BreathOfHope/Respirator-2/Electronics/BoHv1_0_Front.png

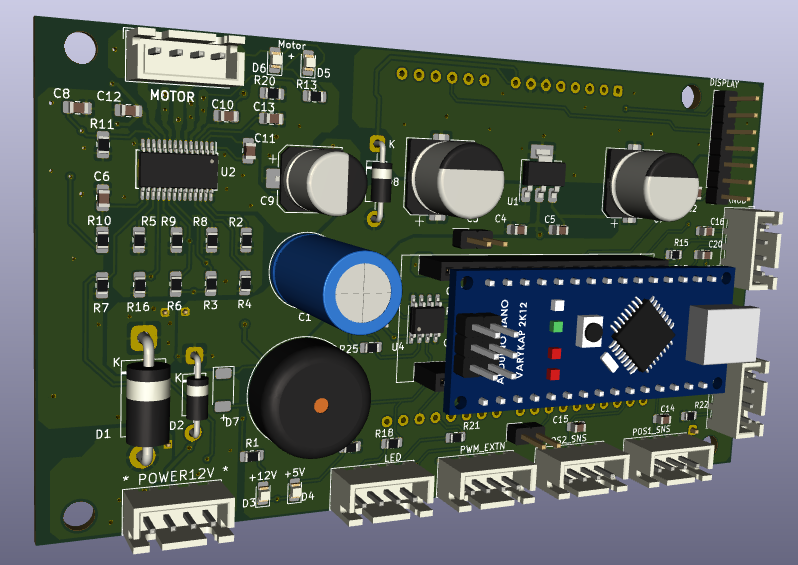
Electronics/BoHv1_0_Front.png
