BreathOfHope/Respirator-2/README.md

# Respirator-2

Respirator-2 takes the knowledge we gained in building the RespiratorApparatus to build a production ready version, that can be manufactured in an industrial setting. If a dire situation arises, this design can be used to mass produce respirators.
