BreathOfHope/Respirator-2/Electronics/PCB_Layout/readme.txt

Project and library files for KiCad based layout, in case you want to modify the layout, else use the gerber files direct.
Use the contents from pretty library for the footprints, some have custom properties.
The project (.pro) file has the reference to the schematics (.sch) and layout(.kicad_pcb) as well as the preferences.
