BreathOfHope/Respirator-2/Electronics/schematic/v0.1/Readme.txt

gEDA based schematics and their pdf versions
Component footprints are hidden but can be edited after selecting the individual component

Modifications needed : Use A4 & A5 pins of the Arduino Nano instead of A6-A7 for the rotary encoder connections. Arduino Uno, if used, would not need any changes.
