BreathOfHope/Respirator-2/Electronics/BoHv1_0_Back.png

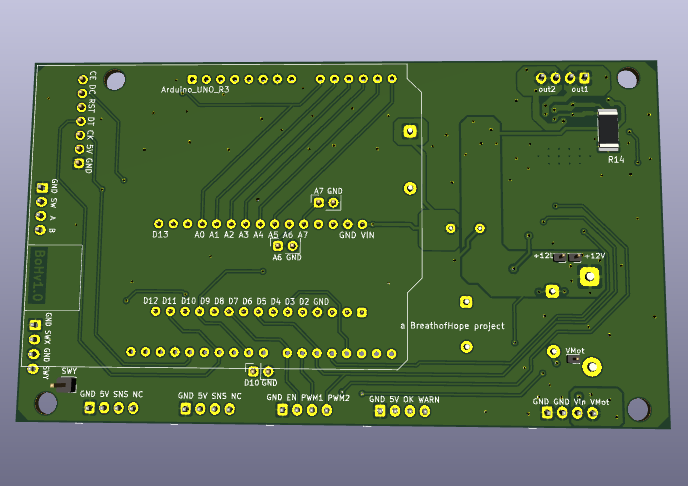
Electronics/BoHv1_0_Back.png
