BreathOfHope/Respirator-2/Mechanical/Respirator mechanical BOM.ods

Part no. | Part name | Material | Unit cost | Quantity | Total cost | Process | Mass(g)
1 | Flange bush | En8 | 150 | 2 | 300 | Turning | 51
2 | Brass bush | Brass | 30 | 2 | 60 | Turning | 20
3 | Frame spacer | En8 | 80 | 4 | 320 | Turning | 96
4 | Crank | MS | 60 | 1 | 60 | Laser cutting | 28.4
5 | Arm spacer | En8 | 80 | 2 | 160 | Turning | 32
6 | Brass bush A | Brass | 60 | 1 | 60 | Turning | 15
7 | Encoder shaft | En8 | 120 | 1 | 120 | Turning | 12
8 | Encoder bush | Al | 100 | 1 | 100 | Turning | 7
9 | Main shaft | En8 | 300 | 1 | 300 | Turning,Milling | 42.6
10 | Brass bush B | Brass | 100 | 1 | 100 | Turning | 16.85
11 | Driven gear insert | Delrin | 120 | 1 | 120 | Turning | 12
12 | Driver geart insert | Delrin | 120 | 1 | 120 | Turning | 9
13 | Frame | MS | 150 | 2 | 300 | Laser cutting | 804.4
14 | Sensor mount | MS | 60 | 1 | 60 | Laser cutting | 117.5
15 | Side bracket | MS | 60 | 2 | 120 | Laser cutting | 184
16 | Power supply mount | MS | 100 | 1 | 200 | Laser cutting | 433
17 | Bottom cover | MS | 250 | 1 | 250 | Laser cutting | 1862.5
18 | Arm plate | MS | 50 | 1 | 50 | Laser cutting | 48
19 | Motor bracket | MS | 100 | 1 | 100 | Laser cutting | 128
20 | Bracket 1 | MS | 50 | 1 | 50 | Laser cutting | 28
21 | Pcb mount | MS | 70 | 1 | 70 | Laser cutting | 259
22 | Enclosure side | MS | 400 | 1 | 400 | Laser cutting | 1682
23 | Encoder cover | MS | 100 | 1 | 100 | Laser cutting | 115
24 | Enclosure top | MS | 150 | 1 | 150 | Laser cutting | 665.27
25 | Enclosure front | MS | 150 | 1 | 150 | Laser cutting | 445
26 | Door | MS | 150 | 1 | 150 | Laser cutting | 510
27 | Arm | MS | 70 | 2 | 140 | Laser cutting | 260
28 | Magnetic lock bracket | MS | 50 | 1 | 50 | Laser cutting
29 | Encoder disc 1 | Acrylic 2mm | 30 | 1 | 30 | Acrylic laser cutting | 6
30 | Spacer 1 | Acrylic 6mm | 20 | 1 | 20 | Acrylic laser cutting | 6
31 | Spacer 2 | Acrylic 3mm | 20 | 1 | 20 | Acrylic laser cutting | 11
32 | Encoder disc 2 | Acrylic 2mm | 30 | 1 | 30 | Acrylic laser cutting | 3.4
33 | Ambu bag support 1 | Acrylic 6mm | 100 | 1 | 100 | Acrylic laser cutting | 6
34 | Ambu bag support 1 | Acrylic 6mm | 100 | 1 | 100 | Acrylic laser cutting | 60
35 | HMI Acrylic sheet 1 | Acrylic 2mm | 30 | 1 | 30 | Acrylic laser cutting | 60
36 | HMI Acrylic sheet 2 | Acrylic 6mm | 60 | 1 | 60 | Acrylic laser cutting | 25
37 | Pcb acrylic mount | Acrylic 4mm | 80 | 1 | 80 | Acrylic laser cutting | 11
38 | Driver gear | Acrylic 8mm | 150 | 1 | 150 | Acrylic laser cutting | 80
39 | Driven gear | Acrylic 5mm | 50 | 1 | 50 | Acrylic laser cutting | 20
40 | Wiper motor 12v | Lucas TVS | 1400 | 1 | 1400 | OTS | 920
41 | Ambu bag
42 | Rubber platfrom
43 | Arm plate rubber sheet
44 | Leg |  | 20 | 4 | 80 | OTS
45 | Magnetic lock |  | 100 | 1 | 100 | OTS
46 | Nut&Bolts |  | 300 | 1 | 300 | OTS
47 | Door hinge lock |  | 100 | 1 | 100 | OTS
 |  |  |  | Total | 6810 |  | 9091.92
