BreathOfHope/Respirator-2/Mechanical/Acrylic laser cutting/8mm clear.dxf

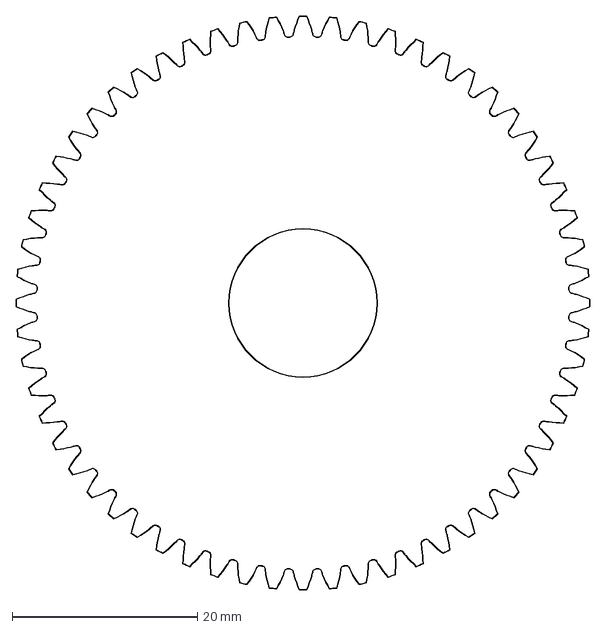
[picture p3: CAD file, 2020-05-19]
Mechanical/Acrylic laser cutting/8mm clear.dxf
62.0 x 62.0 mm
