BreathOfHope/Respirator-2/Mechanical/Metal laser cutting/3mm En8.dxf

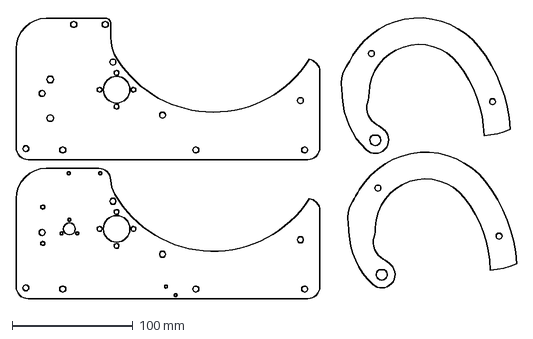
[picture p4: CAD file, 2020-05-19]
Mechanical/Metal laser cutting/3mm En8.dxf
413.9 x 233.5 mm
