BreathOfHope/Respirator-2/Mechanical/Acrylic laser cutting/6mm clear.dxf

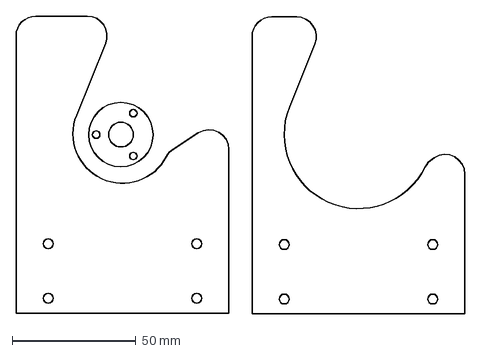
[picture p5: CAD file, 2020-05-19]
Mechanical/Acrylic laser cutting/6mm clear.dxf
181.3 x 120.3 mm
