BreathOfHope/Respirator-2/Mechanical/Metal laser cutting/5mm En8.dxf

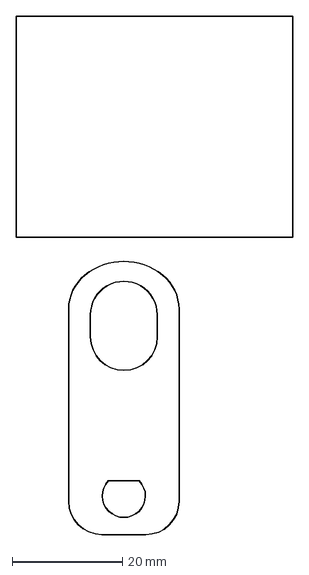
[picture p6: CAD file, 2020-05-19]
Mechanical/Metal laser cutting/5mm En8.dxf
50.0 x 93.8 mm
