BreathOfHope/Respirator-2/Mechanical/Acrylic laser cutting/5mm clear.dxf

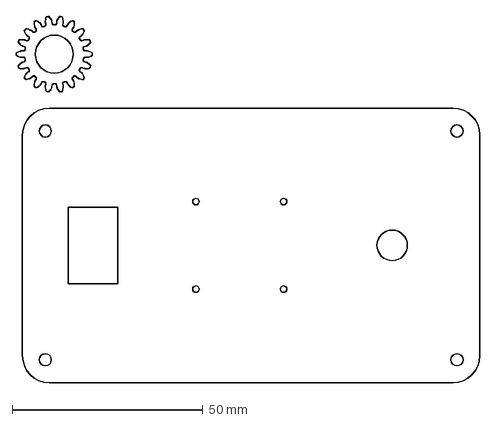
[picture p7: CAD file, 2020-05-19]
Mechanical/Acrylic laser cutting/5mm clear.dxf
121.7 x 96.1 mm
