BreathOfHope/Respirator-2/Mechanical/Metal laser cutting/1.5mm En8.dxf

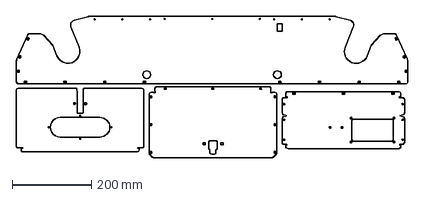
[picture p8: CAD file, 2020-05-19]
Mechanical/Metal laser cutting/1.5mm En8.dxf
986.9 x 356.1 mm
