BreathOfHope/Respirator-2/Mechanical/Acrylic laser cutting/2mm black.dxf

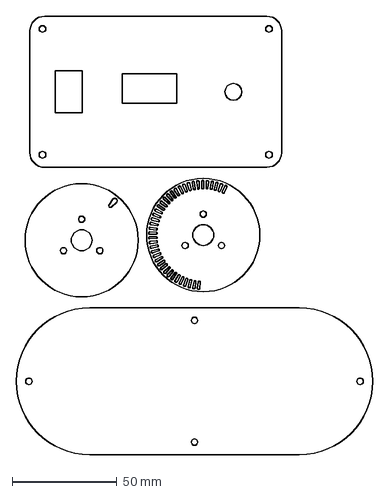
[picture p9: CAD file, 2020-05-19]
Mechanical/Acrylic laser cutting/2mm black.dxf
170.0 x 209.0 mm
