BreathOfHope/Respirator-2/Mechanical/Metal laser cutting/2mm En8.dxf

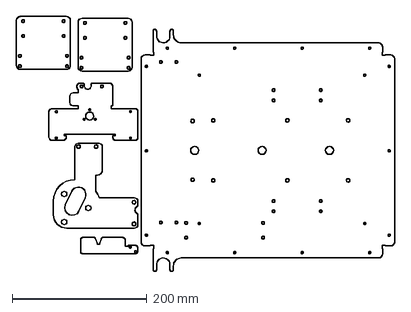
[picture p10: CAD file, 2020-05-19]
Mechanical/Metal laser cutting/2mm En8.dxf
560.8 x 378.2 mm
