BreathOfHope/Respirator-2/Mechanical/Acrylic laser cutting/4mm clear.dxf

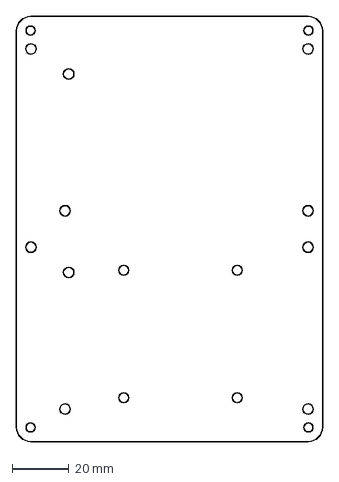
[picture p11: CAD file, 2020-05-19]
Mechanical/Acrylic laser cutting/4mm clear.dxf
108.0 x 150.0 mm
