BreathOfHope/Respirator-2/Mechanical/Metal laser cutting/1mm En8.dxf

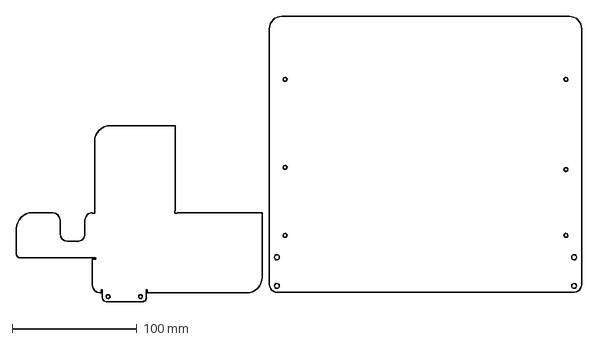
[picture p12: CAD file, 2020-05-19]
Mechanical/Metal laser cutting/1mm En8.dxf
452.7 x 228.6 mm
