BreathOfHope/Respirator-2/Mechanical/Acrylic laser cutting/3mm clear.dxf

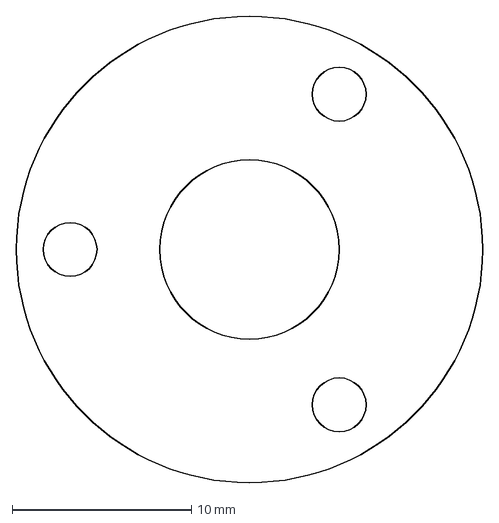
[picture p13: CAD file, 2020-05-19]
Mechanical/Acrylic laser cutting/3mm clear.dxf
26.0 x 26.0 mm
