BreathOfHope/Respirator-2/Electronics/schematic/Resp2.pdf

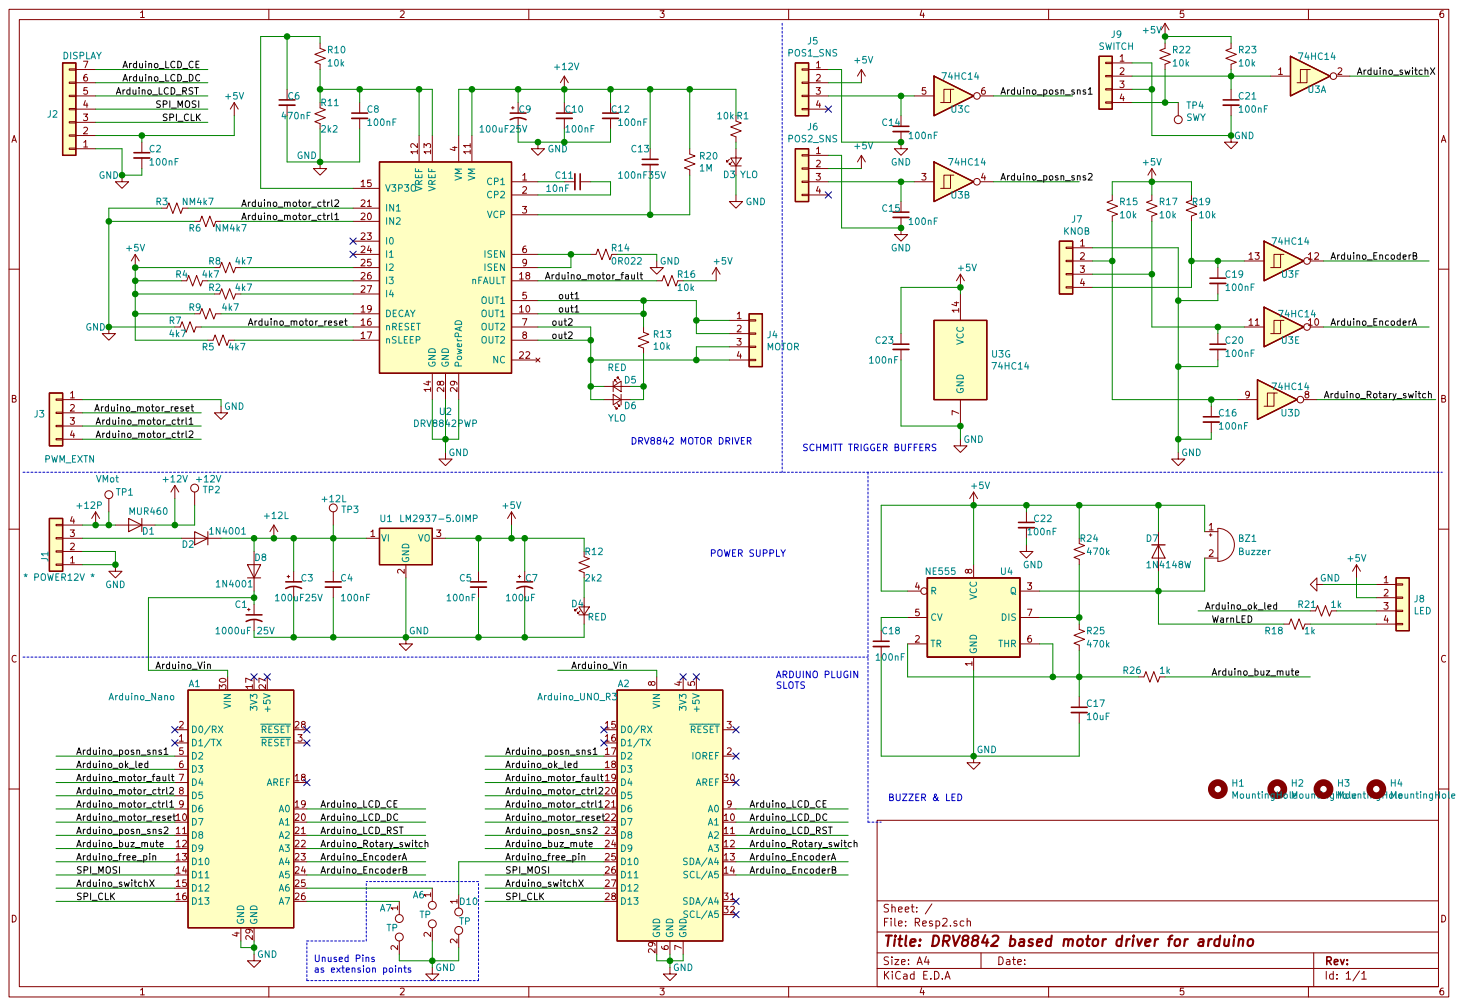
[picture p14: page 1]

SCHMITT TRIGGER BUFFERS DRV8842 MOTOR DRIVER

ARDUINO PLUGIN SLOTS Unused Pins as extension points

File: Resp2.sch Sheet: /
D Date: KiCad E.D.A
Id: 1/1 Title: DRV8842 based motor driver for arduino
