BreathOfHope/Respirator-2/Mechanical/Machining drawings/01 Flange bush.pdf

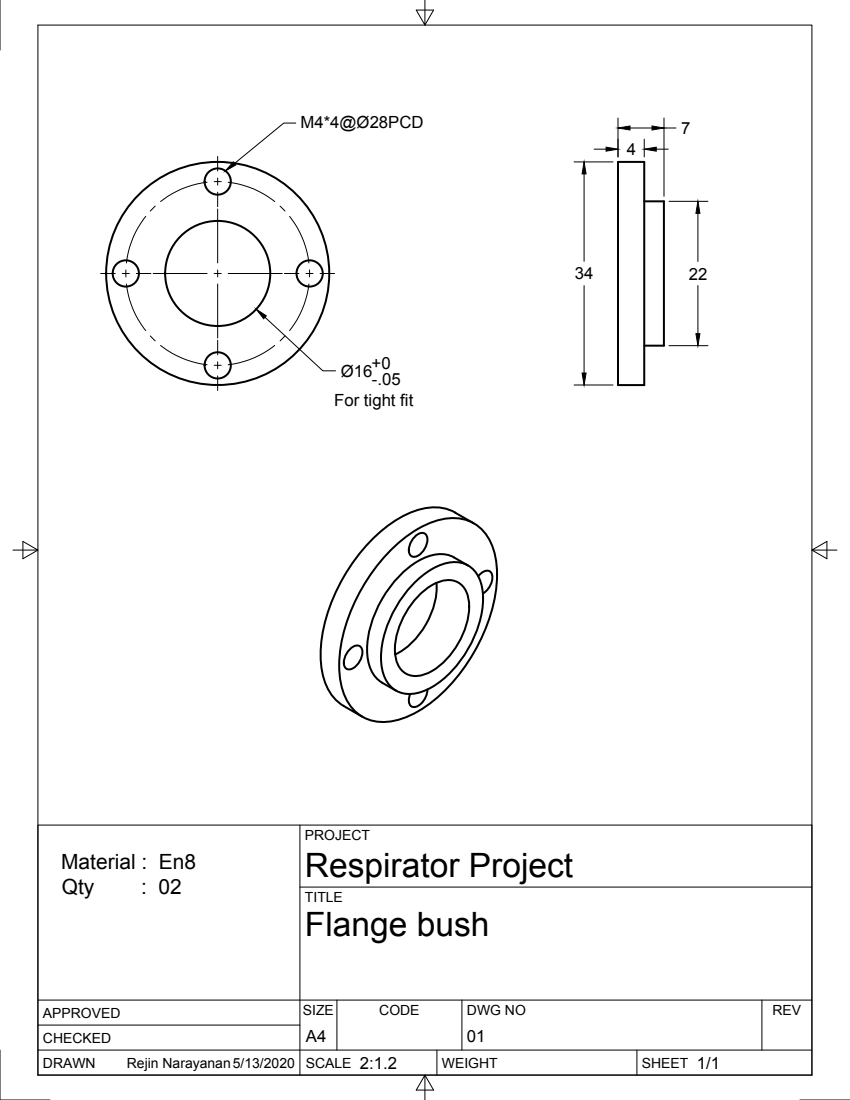
[picture p15: page 1]
SIZE; CODE; DWG NO; REV; Rejin Narayanan5/13/2020; Respirator Project; Flange bush; Material : En8; Qty; For tight fit
