BreathOfHope/Respirator-2/Mechanical/Machining drawings/02 Brass bush.pdf

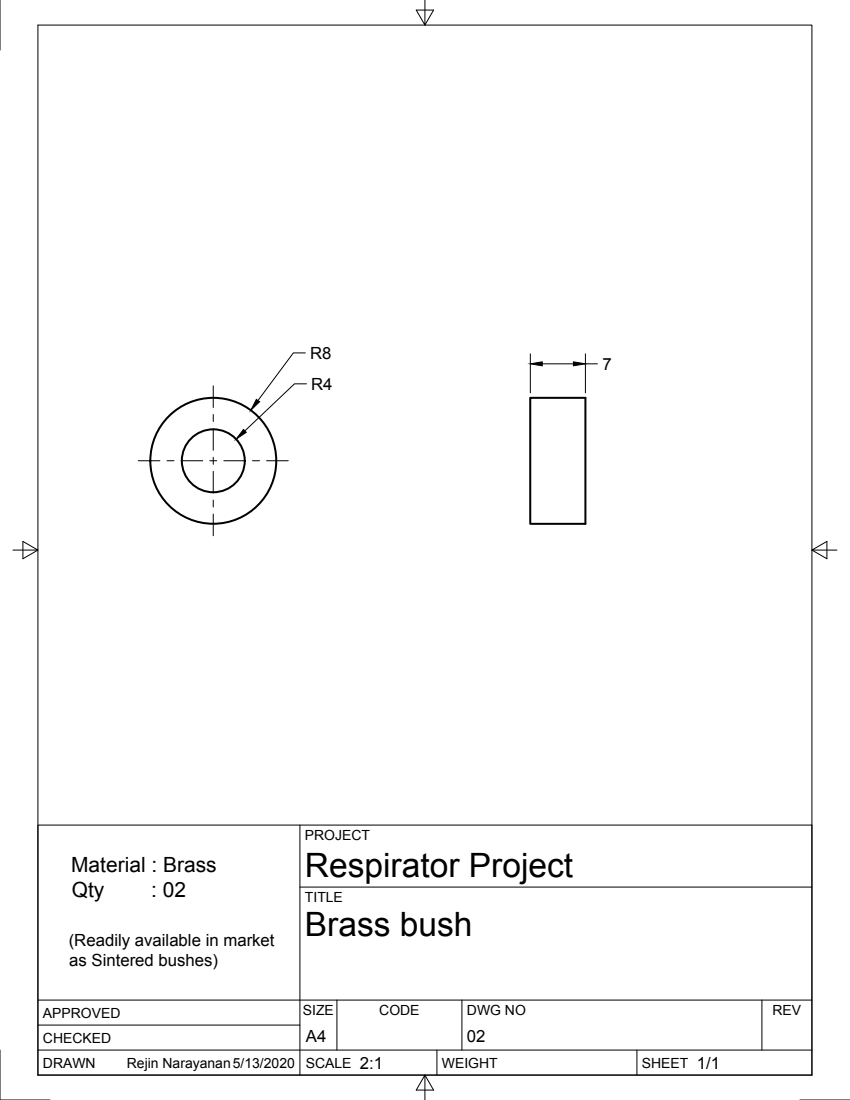
[picture p16: page 1]
SIZE; CODE; DWG NO; REV; Rejin Narayanan5/13/2020; Respirator Project; Brass bush; Material : Brass; Qty

(Readily available in market
as Sintered bushes)
