BreathOfHope/Respirator-2/Mechanical/Machining drawings/03 Frame spacer.pdf

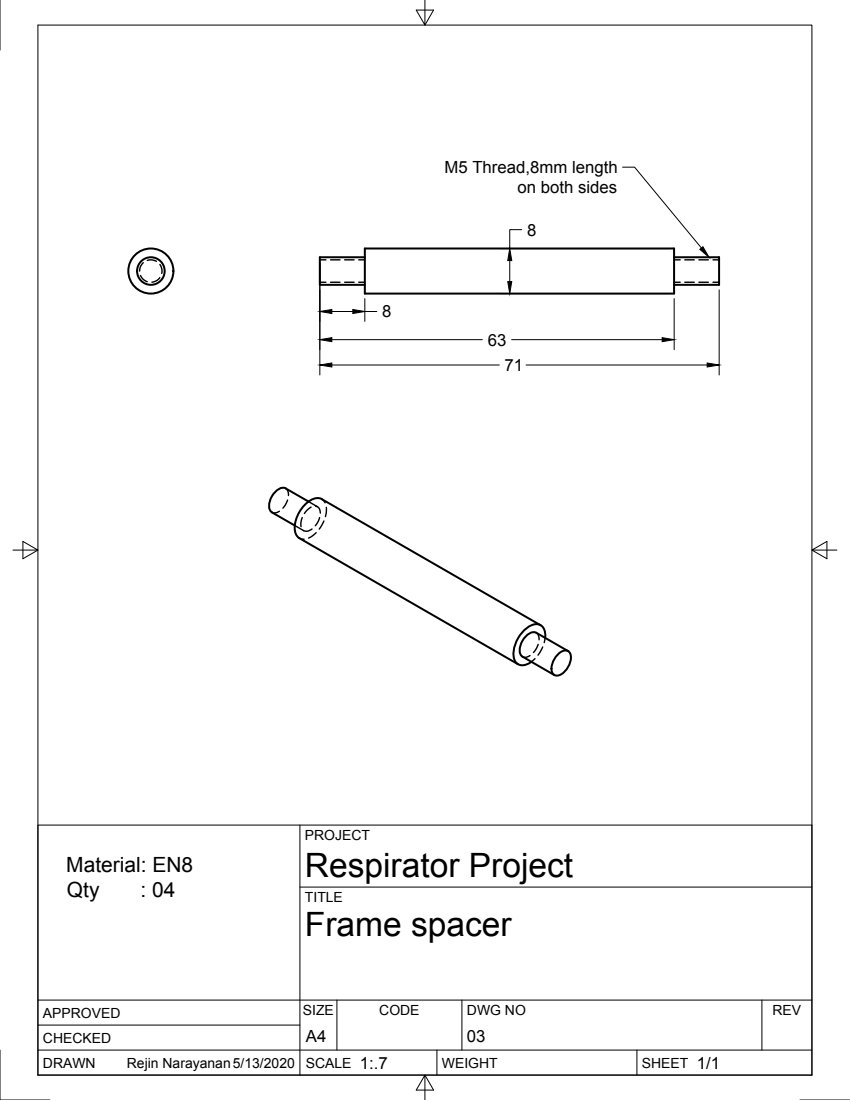
[picture p17: page 1]
SIZE; CODE; DWG NO; REV; Rejin Narayanan5/13/2020; Respirator Project; Frame spacer; M5 Thread,8mm length; Material: EN8; Qty

on both sides
