BreathOfHope/Respirator-2/Mechanical/Machining drawings/04 Crank.pdf

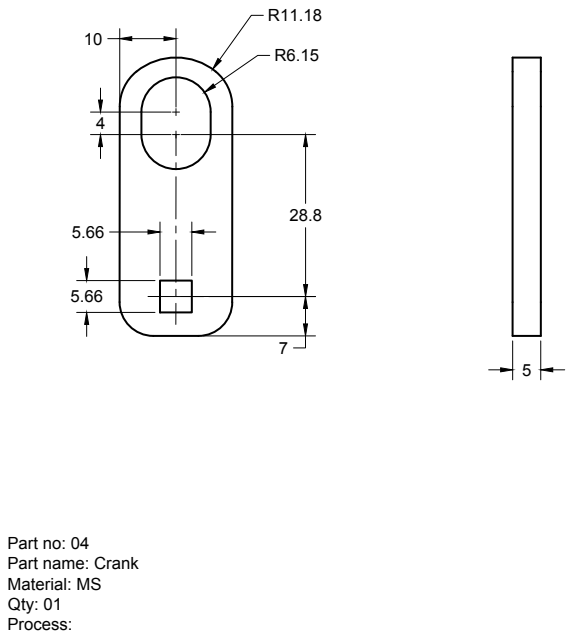
[picture p18: page 1]

Part no: 04
Part name: Crank
Material: MS
Qty: 01
Process:
