BreathOfHope/Respirator-2/Mechanical/Machining drawings/05 Arm spacer.pdf

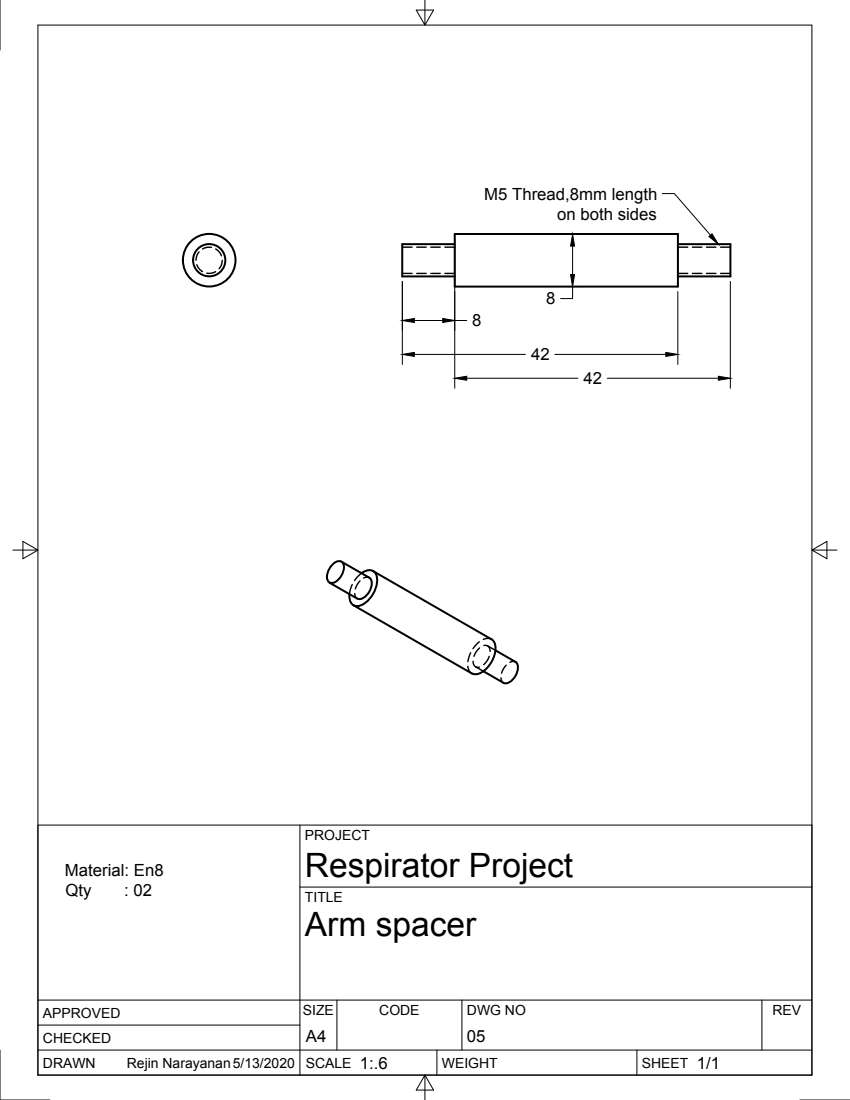
[picture p19: page 1]
SIZE; CODE; DWG NO; REV; Rejin Narayanan5/13/2020; Respirator Project; Arm spacer; M5 Thread,8mm length; Material: En8; Qty

on both sides
