BreathOfHope/Respirator-2/Mechanical/Machining drawings/06 Brass bush A.pdf

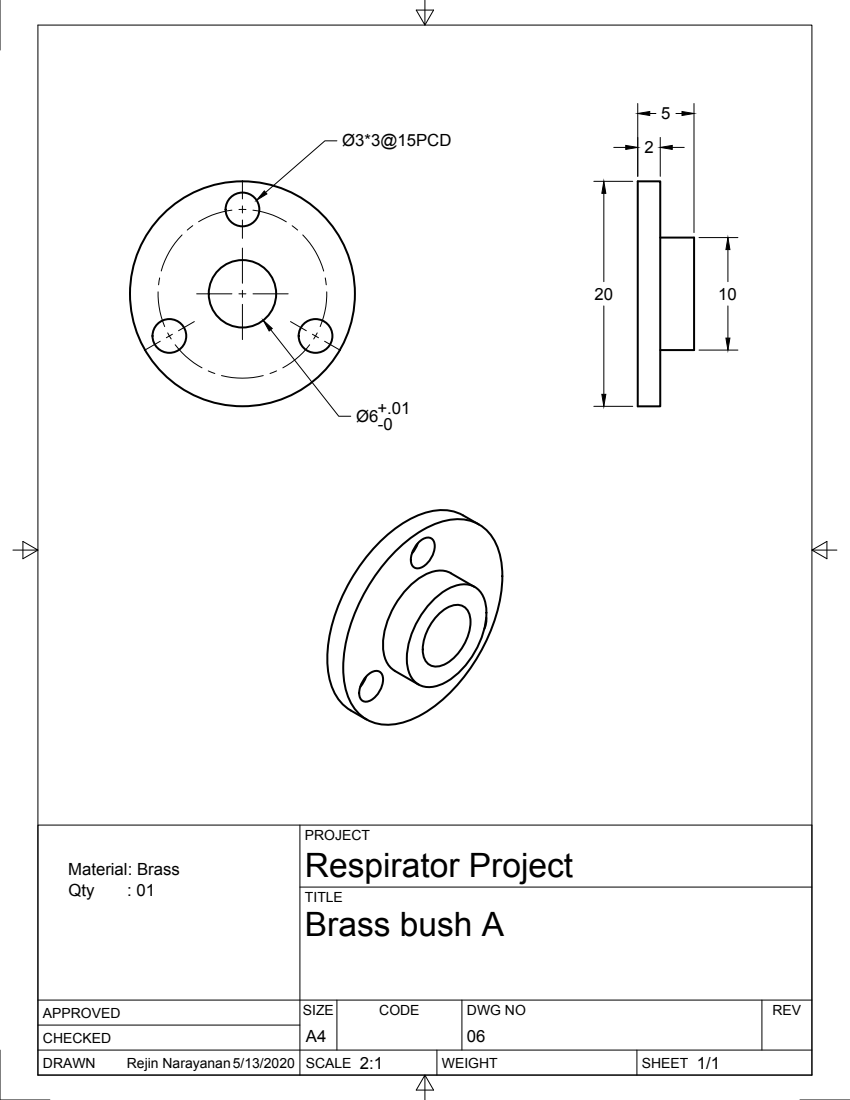
[picture p20: page 1]
SIZE; CODE; DWG NO; REV; Rejin Narayanan5/13/2020; Respirator Project; Brass bush A; Material: Brass; Qty
