BreathOfHope/Respirator-2/Mechanical/Machining drawings/07 Encoder shaft.pdf

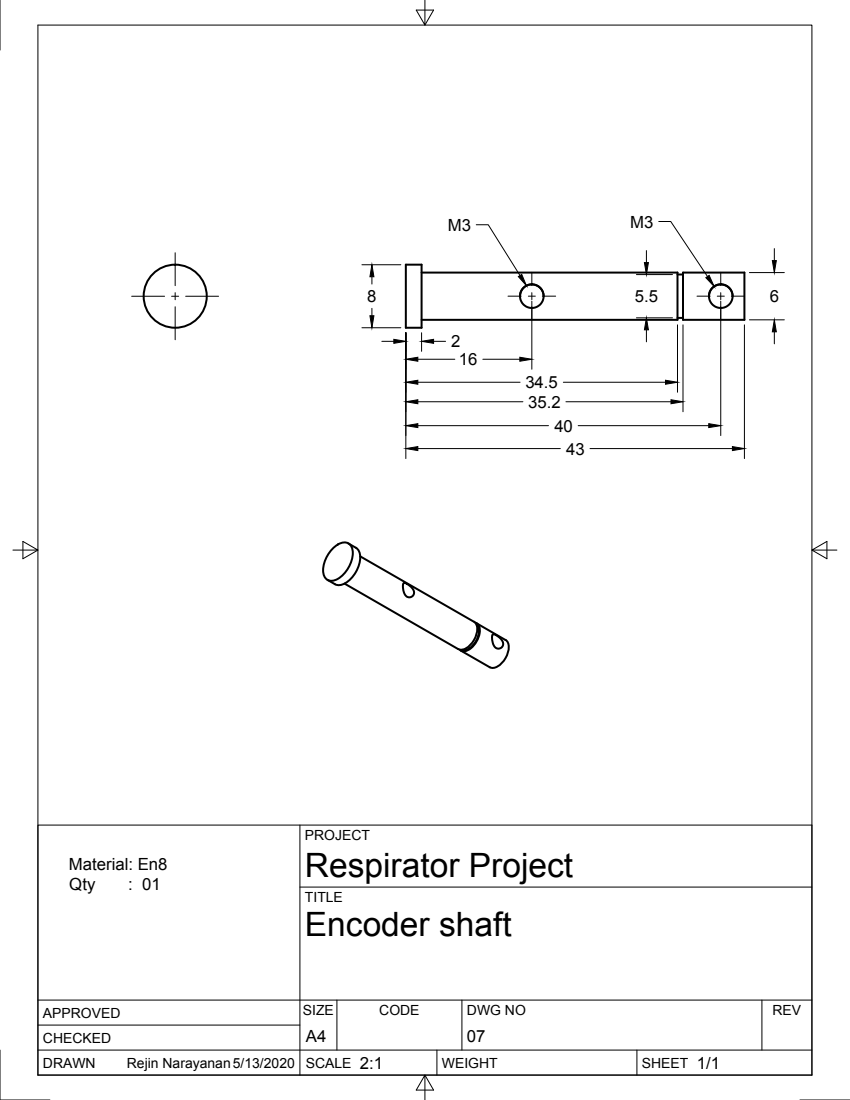
[picture p21: page 1]
SIZE; CODE; DWG NO; REV; Rejin Narayanan5/13/2020; Respirator Project; Encoder shaft; Material: En8; Qty
