BreathOfHope/Respirator-2/Mechanical/Machining drawings/08 Encoder bush.pdf

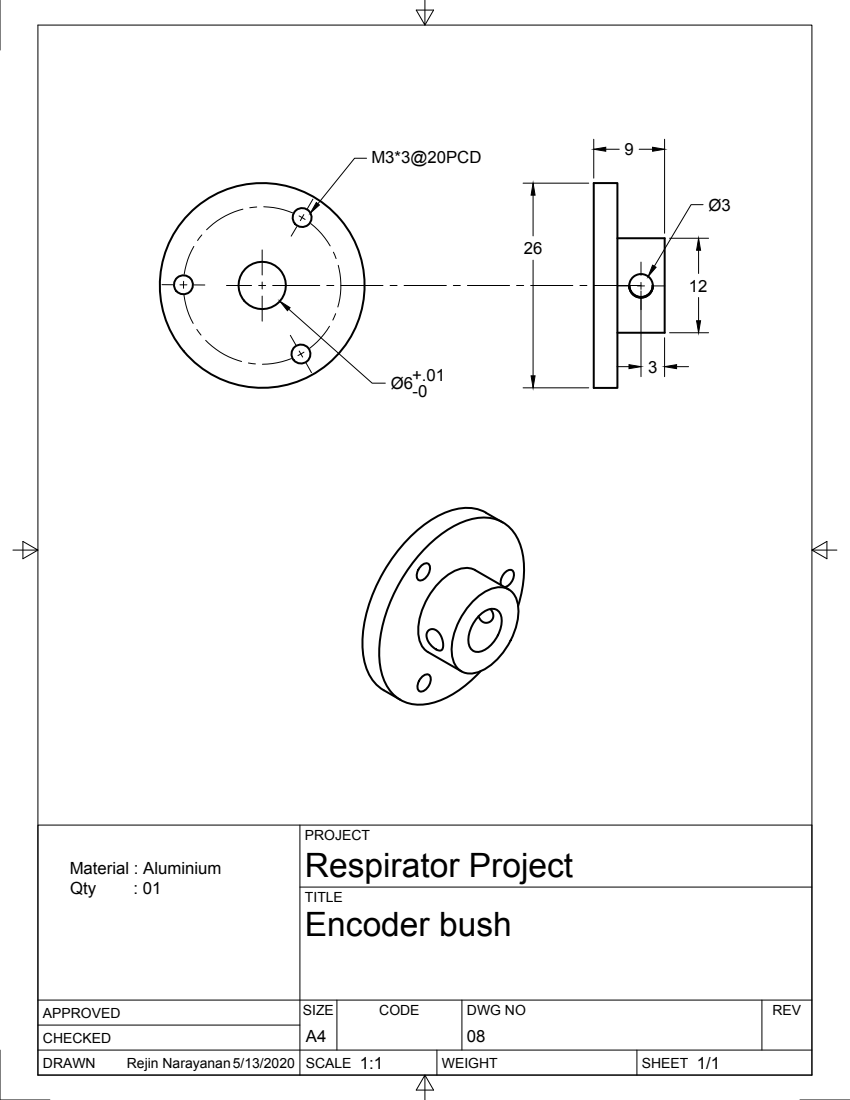
[picture p22: page 1]
SIZE; CODE; DWG NO; REV; Rejin Narayanan5/13/2020; Respirator Project; Encoder bush; Material : Aluminium; Qty
