BreathOfHope/Respirator-2/Mechanical/Machining drawings/09 Main shaft.pdf

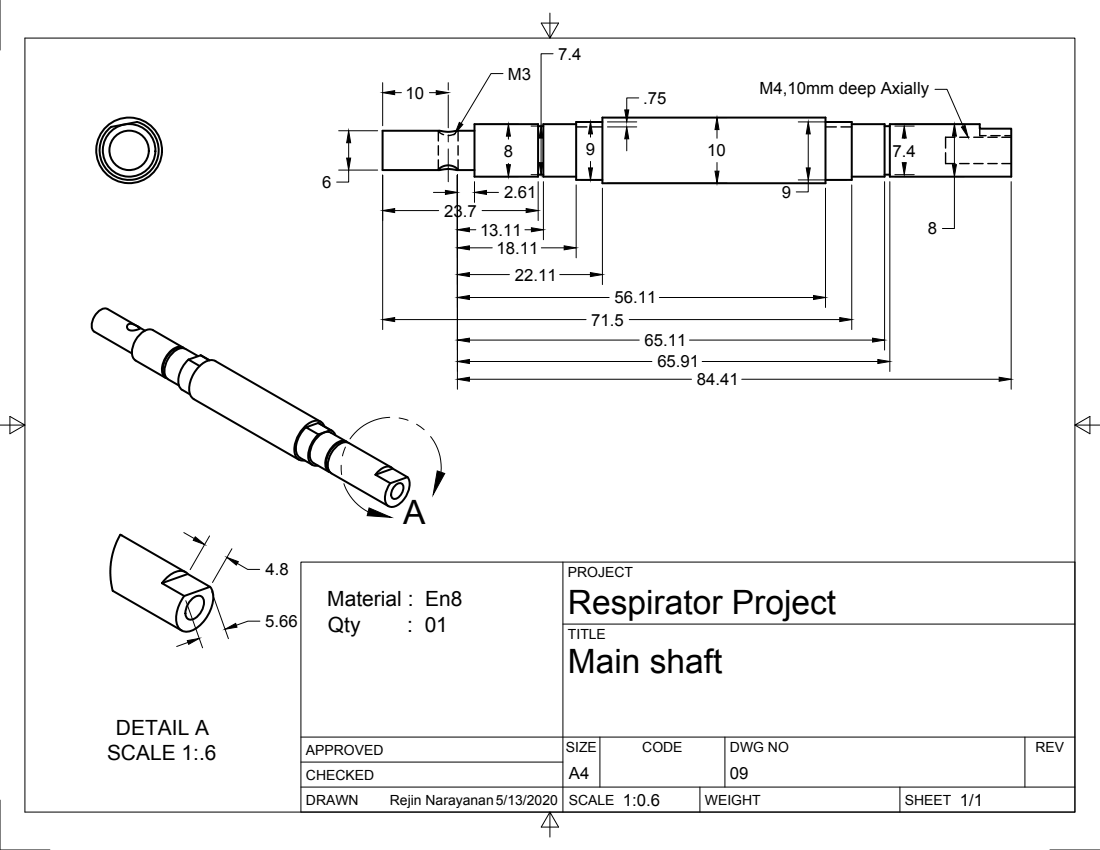
[picture p23: page 1]
SIZE; CODE; DWG NO; REV; Rejin Narayanan5/13/2020; Respirator Project; Main shaft; Material : En8; Qty; M4,10mm deep Axially; DETAIL A SCALE 1:.6
