BreathOfHope/Respirator-2/Mechanical/Machining drawings/10 Brass bush B.pdf

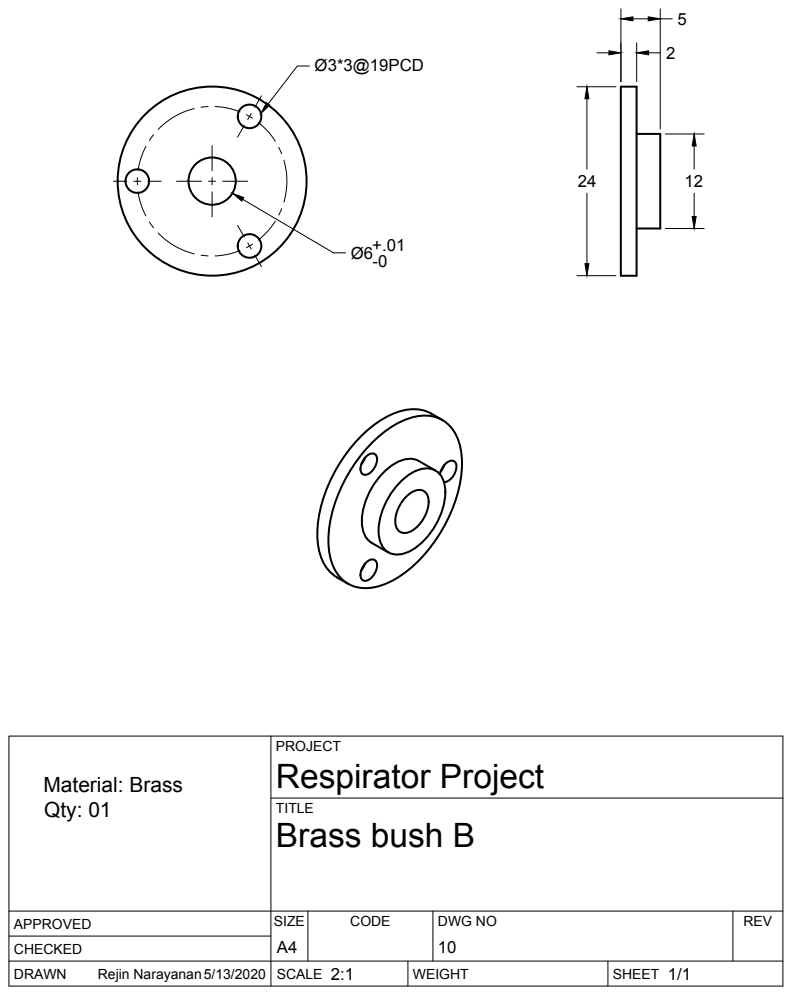
[picture p24: page 1]
SIZE; CODE; DWG NO; REV; Rejin Narayanan5/13/2020; Respirator Project; Brass bush B; Material: Brass Qty: 01
