BreathOfHope/Respirator-2/Mechanical/Machining drawings/11 Driven gear insert.pdf

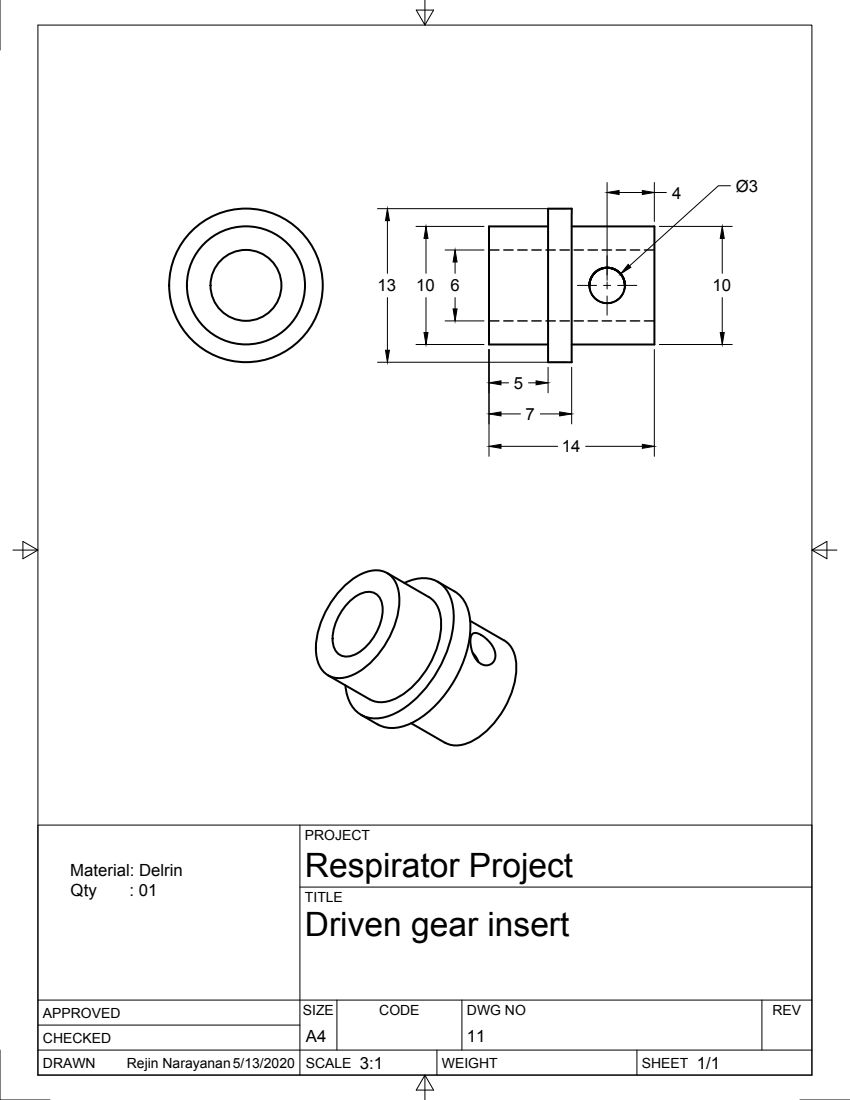
[picture p25: page 1]
SIZE; CODE; DWG NO; REV; Rejin Narayanan5/13/2020; Material: Delrin; Qty

PROJECT
Respirator Project
Driven gear insert
