BreathOfHope/Respirator-2/Mechanical/Machining drawings/12 Driver gear insert.pdf

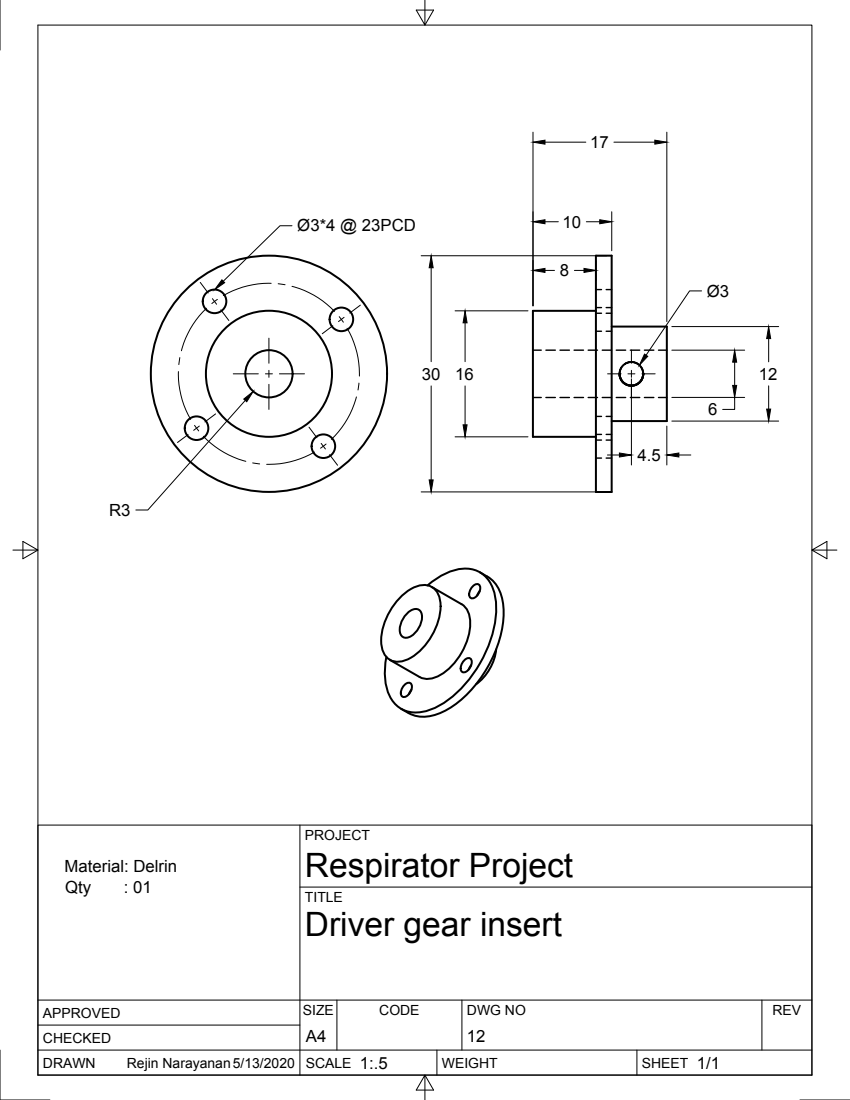
[picture p26: page 1]
SIZE; CODE; DWG NO; REV; Rejin Narayanan5/13/2020; Ø3*4 @ 23PCD; Material: Delrin; Qty

PROJECT
Respirator Project
Driver gear insert
