BreathOfHope/Respirator-2/Mechanical/Machining drawings/Arm - Crankshaft weld.pdf

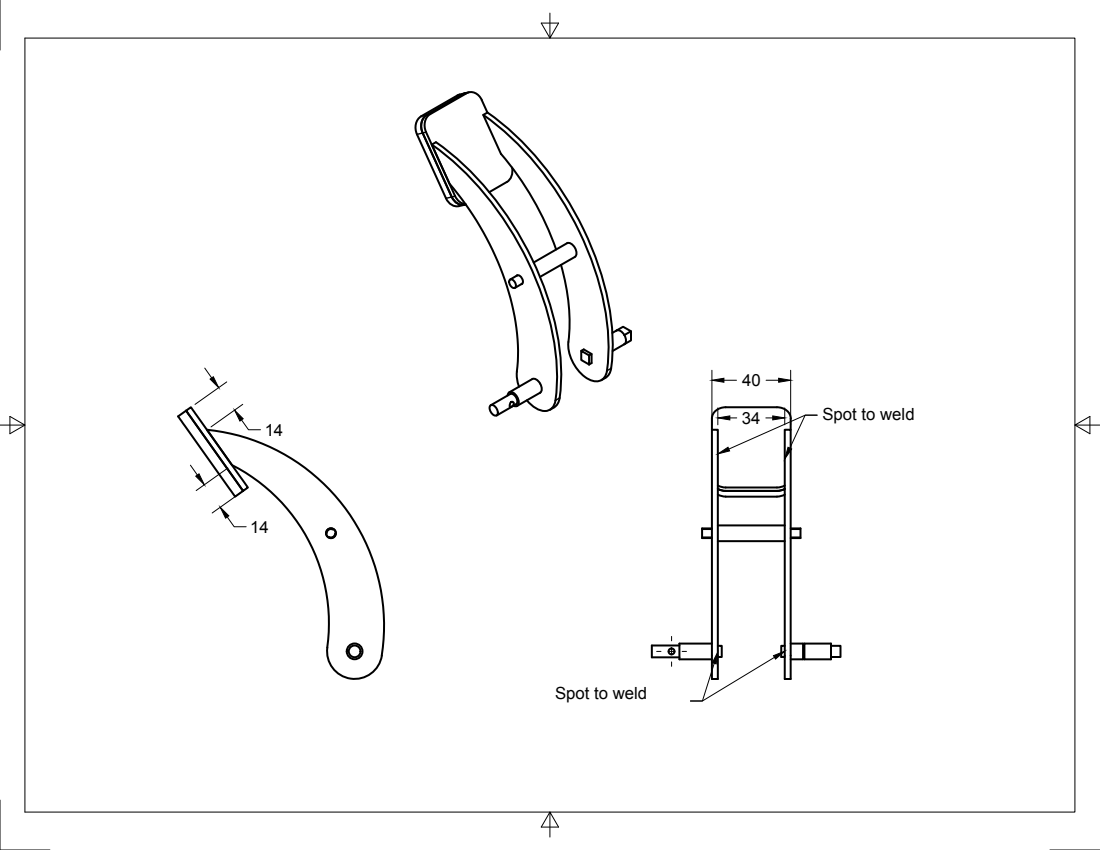
[picture p27: page 1]

Spot to weld
