BreathOfHope/Respirator-2/Electronics/schematic/v0.1/lcd_spi.pdf

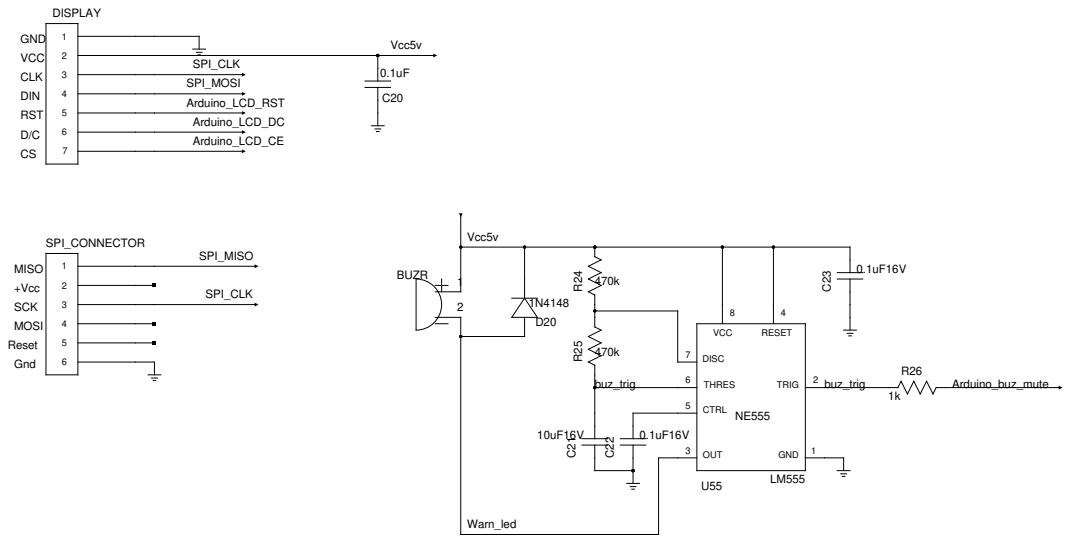
[picture p28: page 1]
SPI_CONNECTOR; MISO; SCK; MOSI; +Vcc; Reset; Gnd; SPI_CLK; Vcc5v; 0.1uF SPI_CLK; SPI_MOSI; Arduino_LCD_RST; Arduino_LCD_CE; Arduino_LCD_DC; DISPLAY; GND; VCC; CLK; DIN; RST; BUZR; Arduino_buz_mute; OUT; CTRL; THRES; DISC; RESET; TRIG; buz_trig; Warn_led; SPI_MISO
