BreathOfHope/Respirator-2/Mechanical/Bending drawings/Bottom cover.pdf

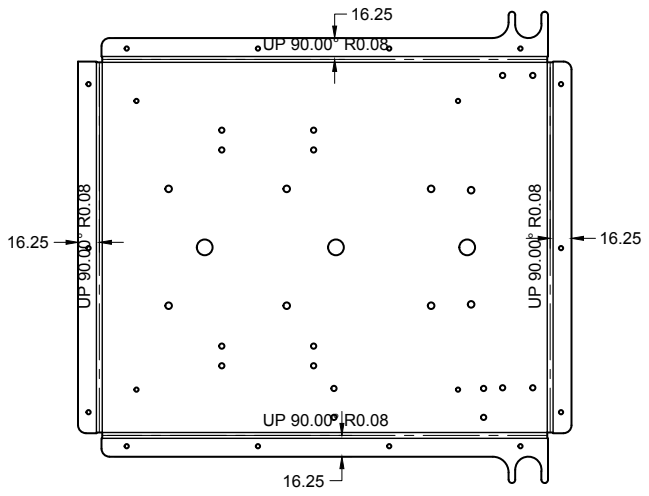
[picture p29: page 1]
