BreathOfHope/Respirator-2/Mechanical/Bending drawings/Bracket 1.pdf

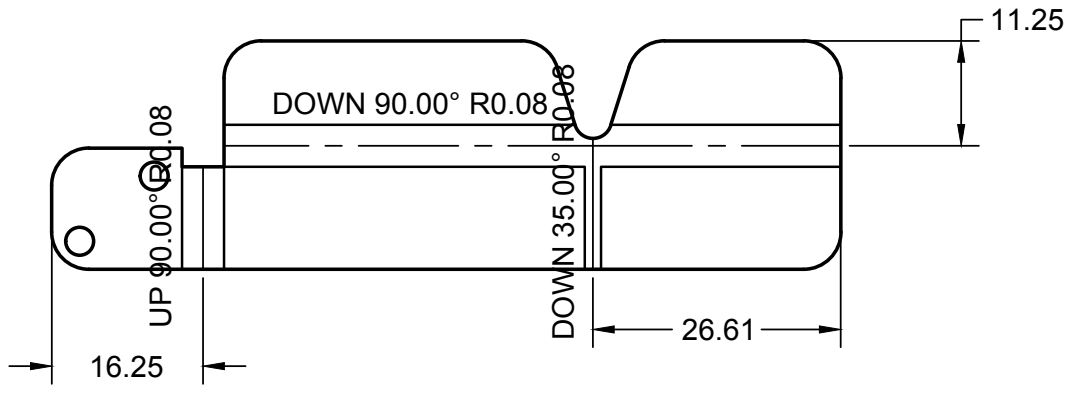
[picture p30: page 1]

DOWN 90.00° R0.08 DOWN 35.00° R0.08 UP 90.00° R0.08
