BreathOfHope/Respirator-2/Mechanical/Bending drawings/Door.pdf

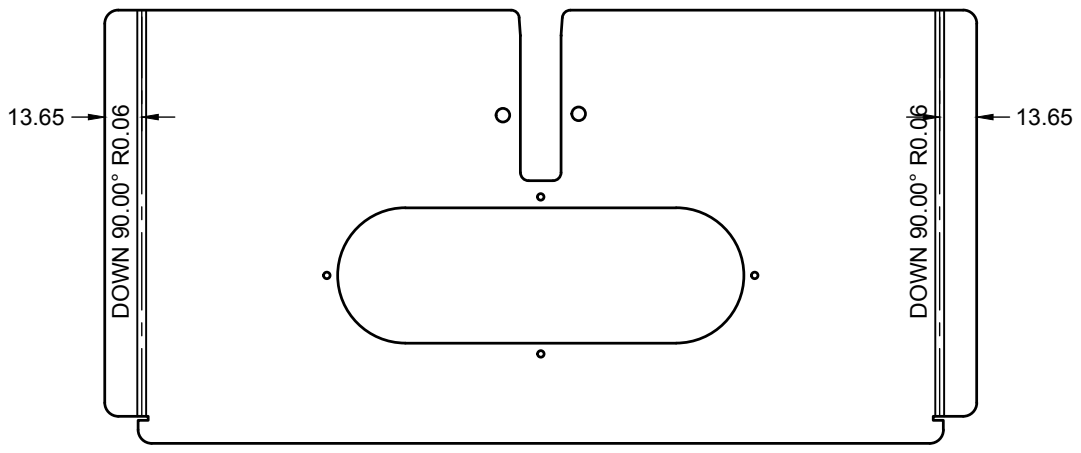
[picture p31: page 1]
13.65 DOWN 90.00° R0.06 DOWN 90.00° R0.06
