BreathOfHope/Respirator-2/Mechanical/Bending drawings/Enclosure side.pdf

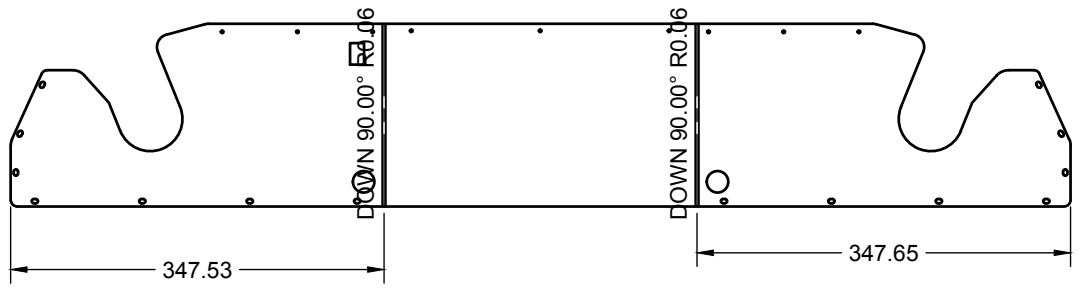
[picture p32: page 1]
347.65 DOWN 90.00° R0.06; DOWN 90.00° R0.06
