BreathOfHope/Respirator-2/Mechanical/Bending drawings/Enclosure top.pdf

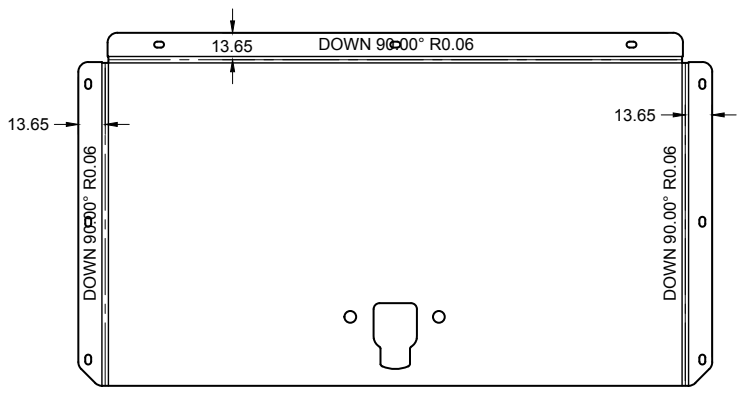
[picture p33: page 1]
DOWN 90.00° R0.06; DOWN 90.00° R0.06 DOWN 90.00° R0.06
