BreathOfHope/Respirator-2/Mechanical/Bending drawings/Frame 1&2 3mm.pdf

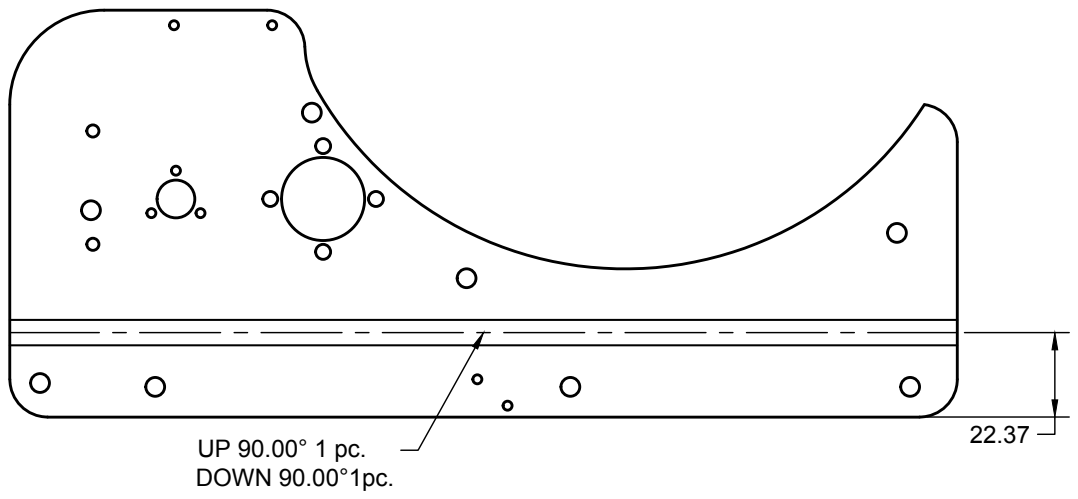
[picture p34: page 1]
DOWN 90.00°1pc.
