BreathOfHope/Respirator-2/Mechanical/Bending drawings/Motor bracket.pdf

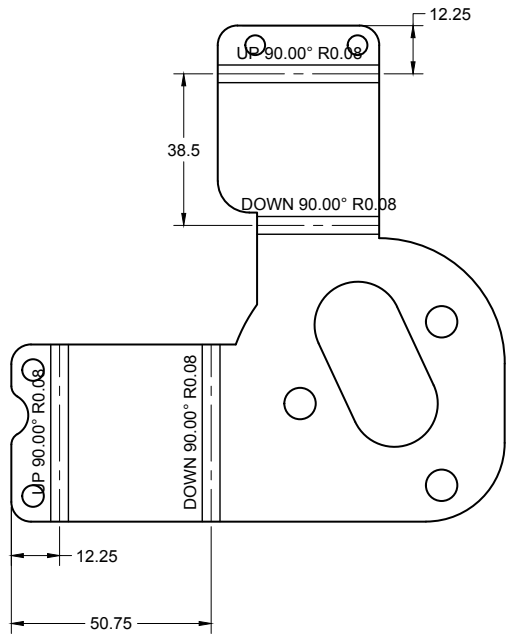
[picture p35: page 1]

DOWN 90.00° R0.08 DOWN 90.00° R0.08 UP 90.00° R0.08
