BreathOfHope/Respirator-2/Mechanical/Bending drawings/Power supply mount.pdf

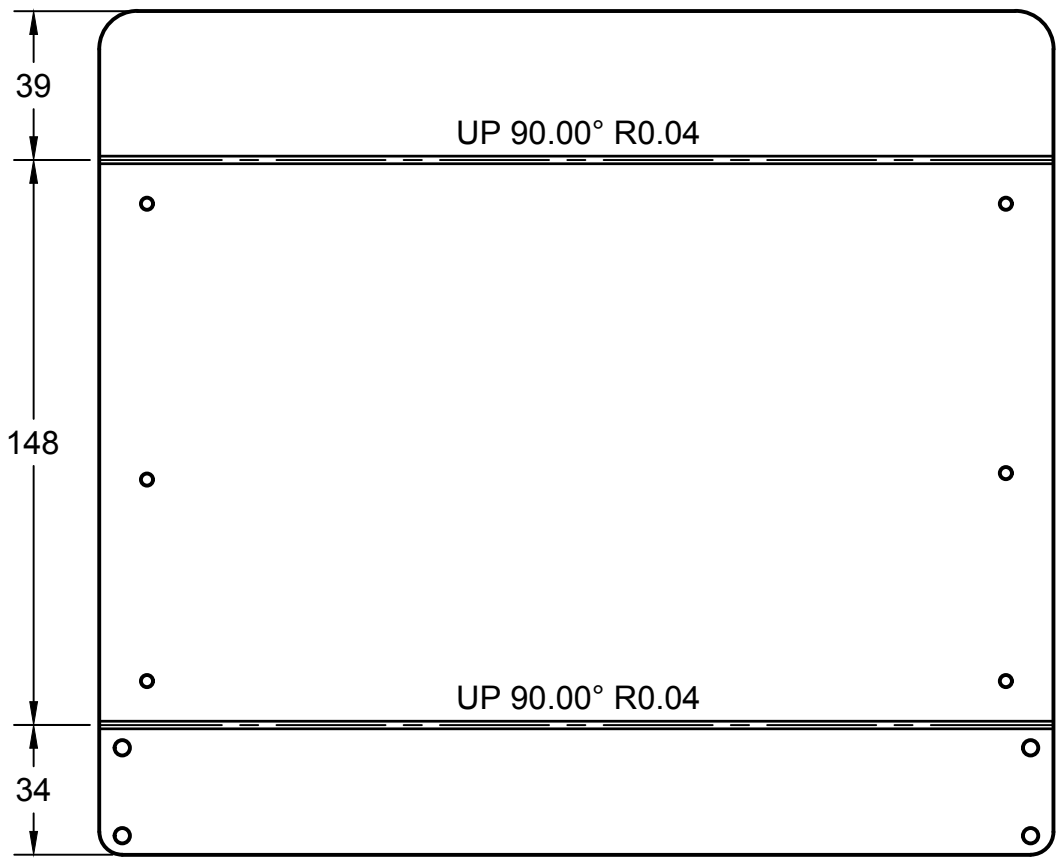
[picture p36: page 1]
