BreathOfHope/Respirator-2/Mechanical/Bending drawings/Sensor mount.pdf

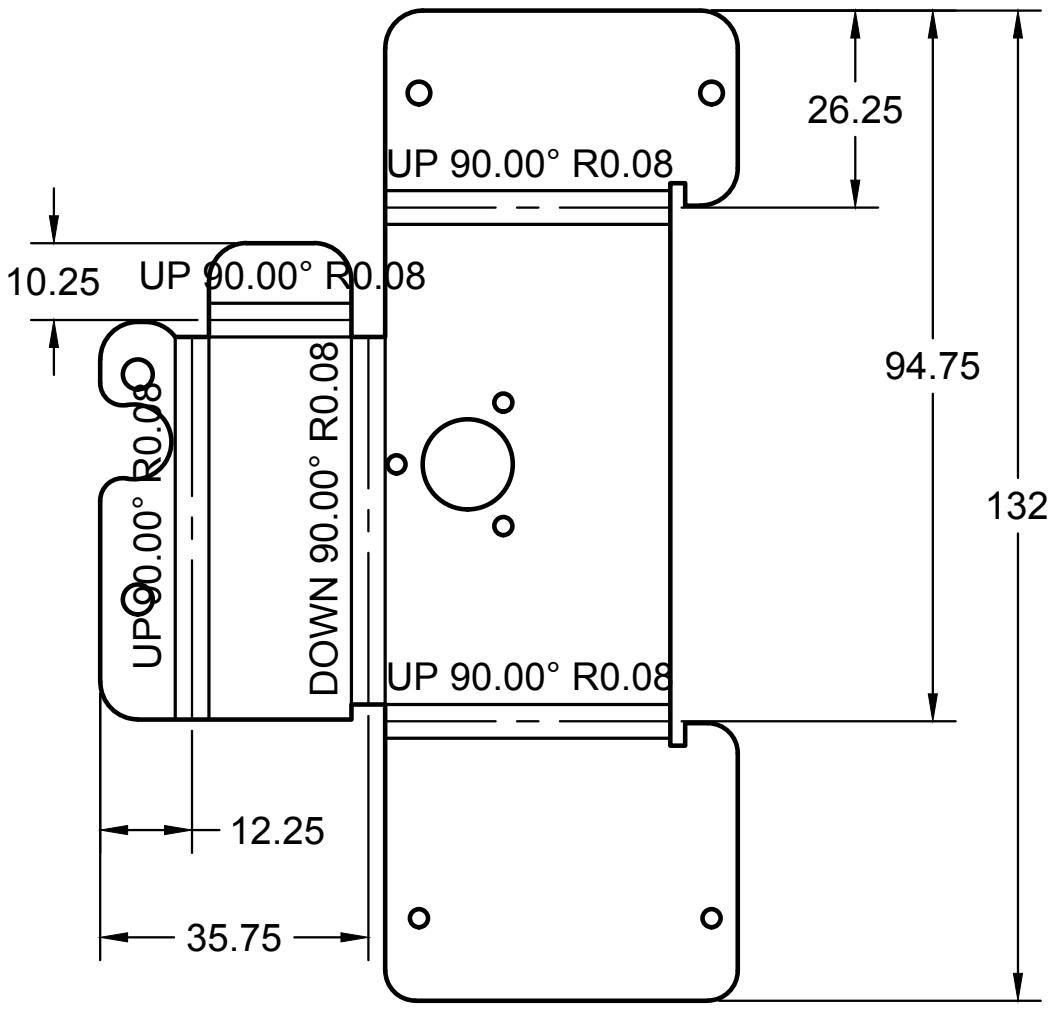
[picture p37: page 1]
UP 90.00° R0.08 DOWN
