BreathOfHope/Respirator-2/Mechanical/Bending drawings/Side bracket 2mm.pdf

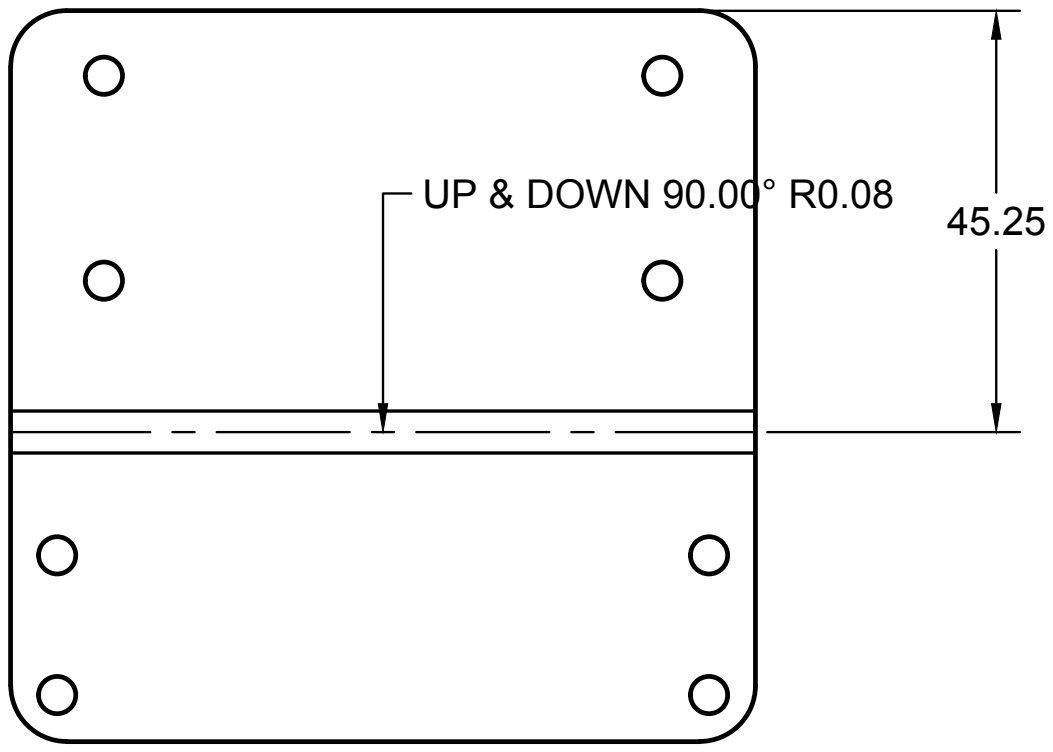
[picture p38: page 1]
45.25 UP & DOWN 90.00° R0.08
