BreathOfHope/Respirator-2/Electronics/schematic/v0.1/DRV8842.pdf

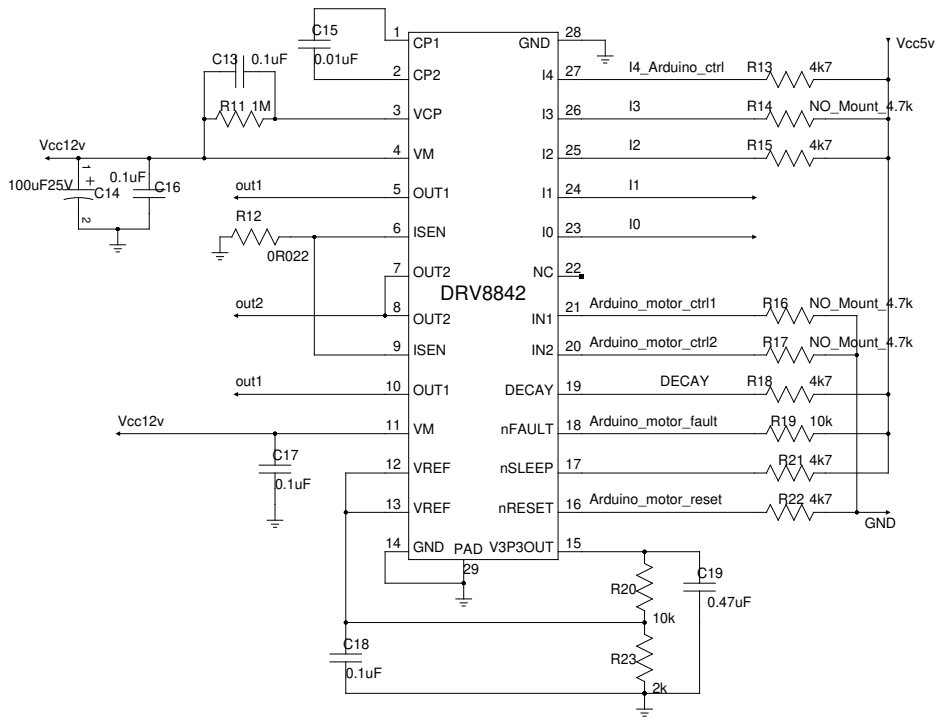
[picture p39: page 1]
