BreathOfHope/Respirator-2/Electronics/schematic/v0.1/power_supply.pdf

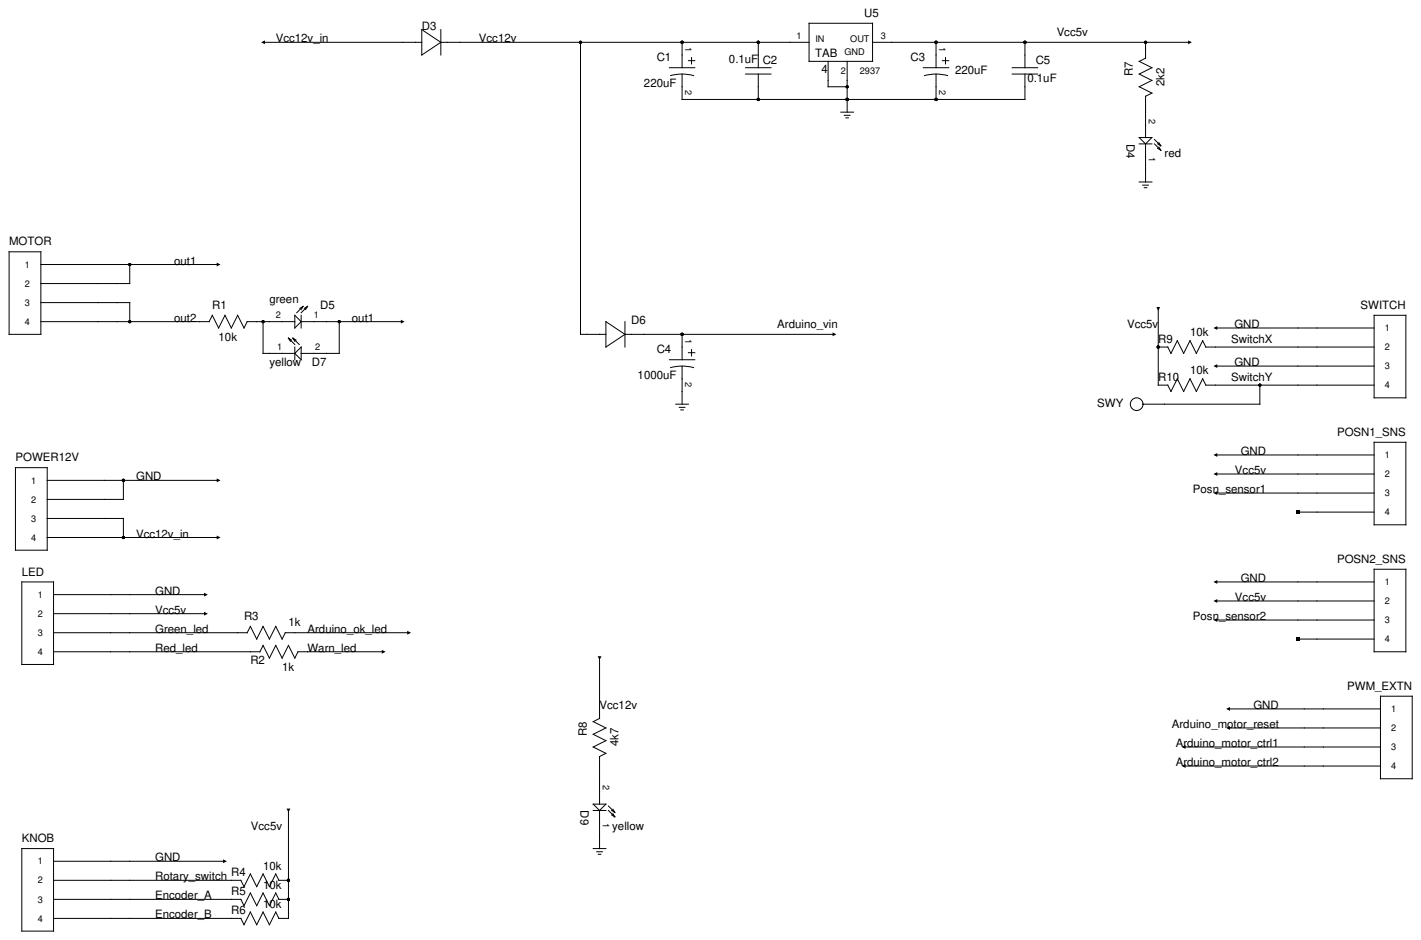
[picture p40: page 1]
