BreathOfHope/Respirator-2/Electronics/schematic/v0.1/schmitt_trigger.pdf

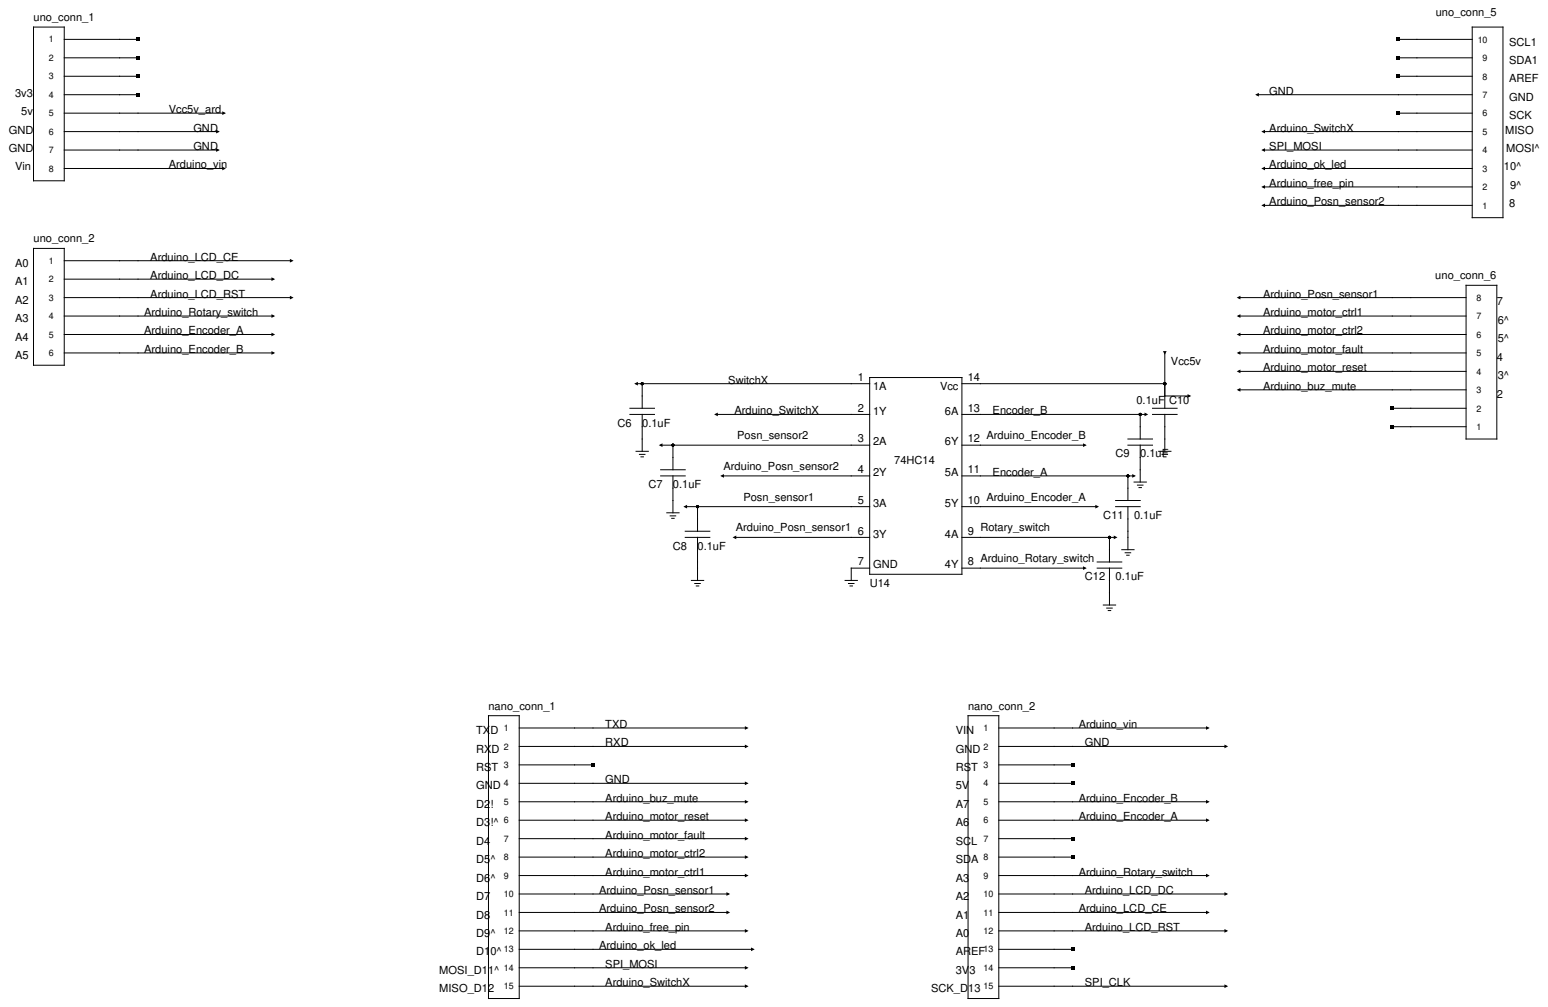
[picture p41: page 1]
