BreathOfHope/Respirator-2/Electronics/PCB_Layout/Resp2.kicad_pcb

## KiCad design Electronics/PCB_Layout/Resp2.kicad_pcb (2020-05-21)

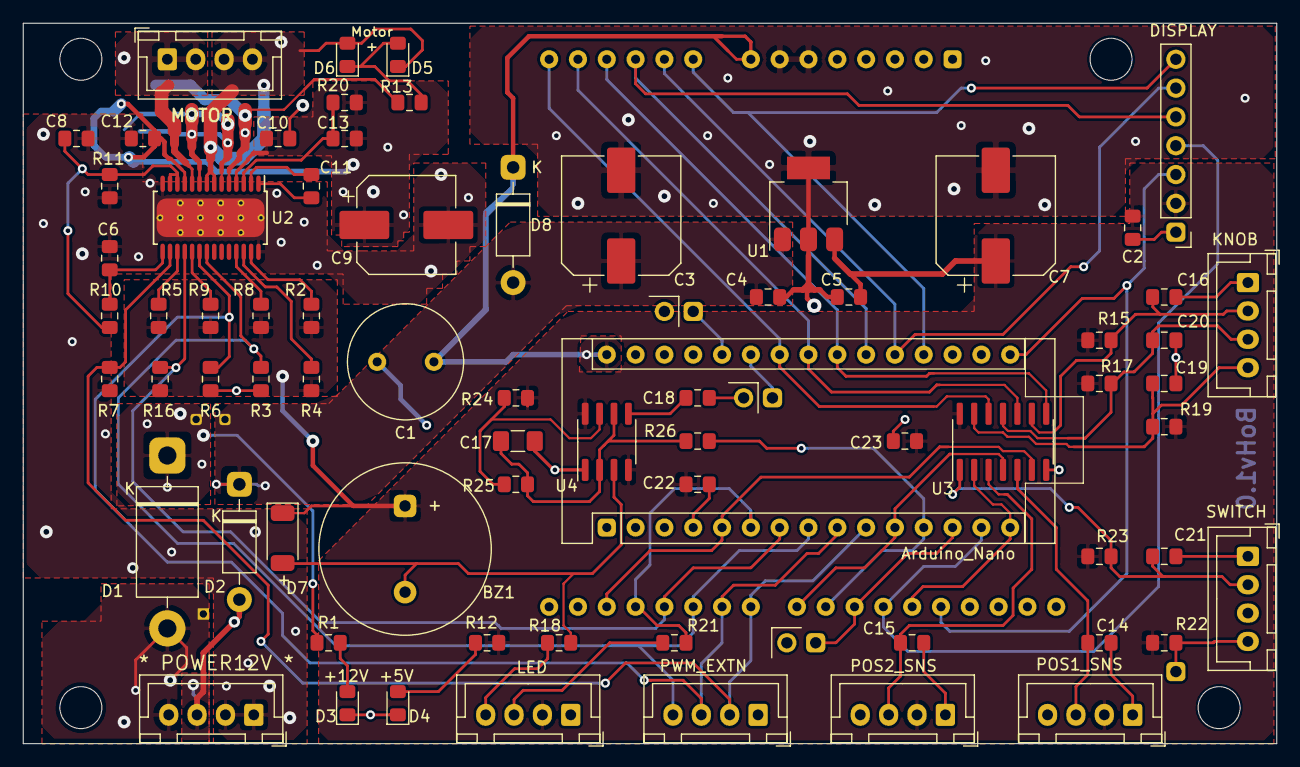
[picture p42: board Resp2.kicad_pcb from above]

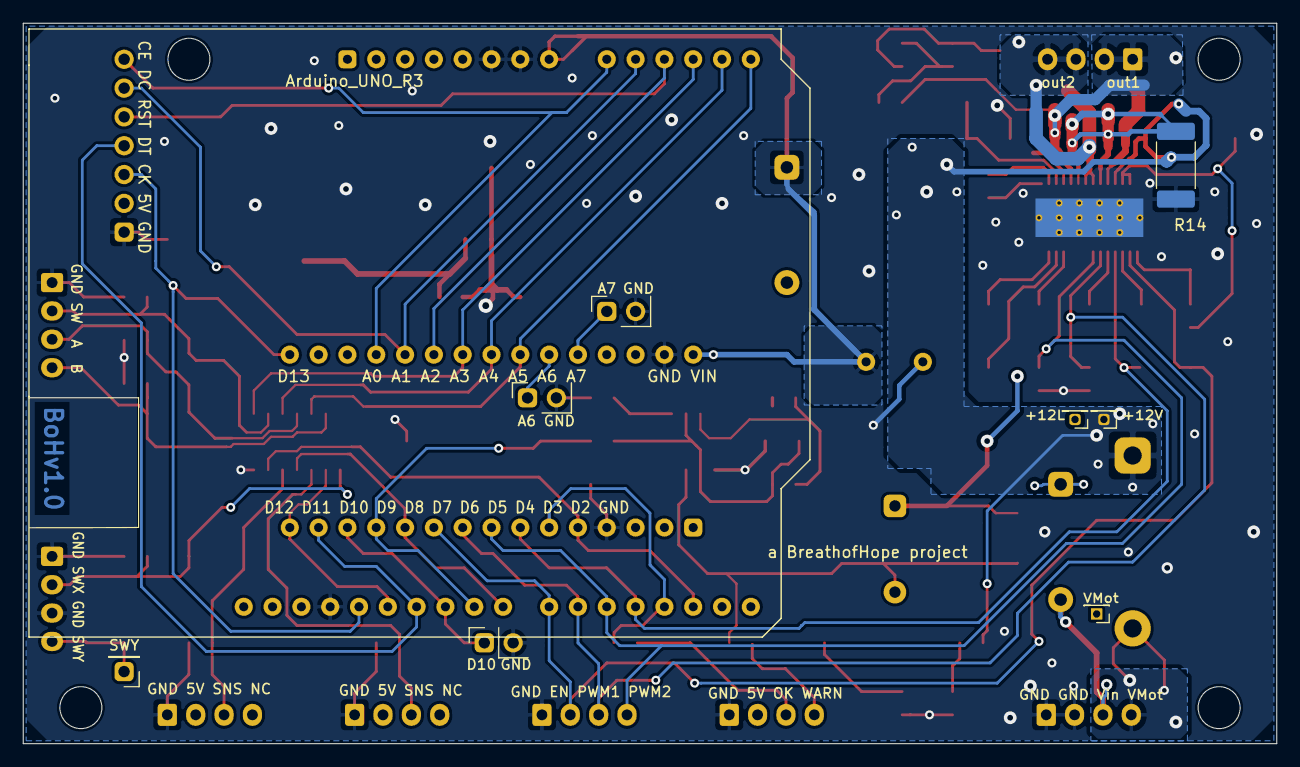
[picture p43: board Resp2.kicad_pcb from below]

Board: 2 copper layers, 110.5 x 63.5 mm, 84 parts (6 on the bottom side), 56 nets.

Parts:
A1: Arduino_Nano
A2: Arduino_UNO_R3
A6, A7: TP; PinHeader_1x02_P2.54mm_Vertical
BZ1: Buzzer; Buzzer_15x7.5RM7.6
C1: 1000uF 25V; C_Radial_D10.0mm_H20.0mm_P5.00mm
C2, C4, C5, C8, C10, C12, C14, C15, C16, C18, C19, C20, C21, C22, C23: 100nF; C_0805_2012Metric_Pad1.15x1.40mm_HandSolder
C3: 100uF25V; CP_Elec_10x10
C6: 470nF; C_0805_2012Metric_Pad1.15x1.40mm_HandSolder
C7: 100uF; CP_Elec_10x10
C9: 100uF25V; CP_Elec_8x10.5
C11: 10nF; C_0805_2012Metric_Pad1.15x1.40mm_HandSolder
C13: 100nF35V; C_0805_2012Metric_Pad1.15x1.40mm_HandSolder
C17: 10uF; C_1206_3216Metric_Pad1.42x1.75mm_HandSolder
D1: MUR460; D_DO-201AD_P15.24mm_Horizontal
D2, D8: 1N4001; D_DO-41_SOD81_P10.16mm_Horizontal
D3, D6: YLO; LED_0805_2012Metric_Pad1.15x1.40mm_HandSolder
D4, D5: RED; LED_0805_2012Metric_Pad1.15x1.40mm_HandSolder
D7: 1N4148W; D_SOD-128
D10: TP; PinHeader_1x02_P2.54mm_Vertical
H1, H2, H3, H4: MountingHole; MountingHole_3.7mm
J1: * POWER12V *; JST_XH_B4B-XH-A_1x04_P2.50mm_Vertical
J2: DISPLAY; PinHeader_1x07_P2.54mm_Vertical
J3: PWM_EXTN; JST_XH_B4B-XH-A_1x04_P2.50mm_Vertical
J4: MOTOR; JST_XH_B4B-XH-A_1x04_P2.50mm_Vertical
J5: POS1_SNS; JST_XH_B4B-XH-A_1x04_P2.50mm_Vertical
J6: POS2_SNS; JST_XH_B4B-XH-A_1x04_P2.50mm_Vertical
J7: KNOB; JST_XH_B4B-XH-A_1x04_P2.50mm_Vertical
J8: LED; JST_XH_B4B-XH-A_1x04_P2.50mm_Vertical
J9: SWITCH; JST_XH_B4B-XH-A_1x04_P2.50mm_Vertical
R1, R10, R13, R15, R16, R17, R19, R22, R23: 10k; R_0805_2012Metric_Pad1.15x1.40mm_HandSolder
R2, R4, R5, R7, R8, R9: 4k7; R_0805_2012Metric_Pad1.15x1.40mm_HandSolder
R3, R6: NM4k7; R_0805_2012Metric_Pad1.15x1.40mm_HandSolder
R11, R12: 2k2; R_0805_2012Metric_Pad1.15x1.40mm_HandSolder
R14: 0R022; R_2512_6332Metric_Pad1.52x3.35mm_HandSolder
R18, R21, R26: 1k; R_0805_2012Metric_Pad1.15x1.40mm_HandSolder
R20: 1M; R_0805_2012Metric_Pad1.15x1.40mm_HandSolder
R24, R25: 470k; R_0805_2012Metric_Pad1.15x1.40mm_HandSolder
TP1: VMot; PinHeader_1x01_P1.27mm_Vertical
TP2: +12V; PinHeader_1x01_P1.27mm_Vertical
TP3: +12L; PinHeader_1x01_P1.27mm_Vertical
TP4: SWY; PinHeader_1x01_P2.54mm_Vertical
U1: LM2937xMP; SOT-223-3_TabPin2
U2: DRV8842PWP; HTSSOP-28-1EP_4.4x9.7mm_P0.65mm_EP3.4x9.5mm_ThermalVias
U3: 74HC14; SOIC-14_3.9x8.7mm_P1.27mm
U4: NE555; SOIC-8_3.9x4.9mm_P1.27mm

Connections:
+5V: BZ1.1, C2.1, C5.1, C7.1, C22.1, C23.1, D7.1, J2.2, J5.2, J6.2, J8.2, R2.2, R4.2, R5.2, R8.2, R9.2, R12.1, R15.1, R16.1, R17.1, R19.1, R22.1, R23.1, R24.1, U1.3, U3.14, U4.4, U4.8
+12L: C3.1, C4.1, D2.1, D8.2, TP3.1, U1.1
+12P: D1.2, J1.4, TP1.1
+12V: C9.1, C10.1, C12.1, C13.1, D1.1, R1.1, R20.1, TP2.1, U2.4, U2.11
/Arduino_EncoderA: A1.23, A2.13, U3.10
/Arduino_EncoderB: A1.24, A2.14, U3.12
/Arduino_LCD_CE: A1.19, A2.9, J2.7
/Arduino_LCD_DC: A1.20, A2.10, J2.6
/Arduino_LCD_RST: A1.21, A2.11, J2.5
/Arduino_Rotary_switch: A1.22, A2.12, U3.8
/Arduino_Vin: A1.30, A2.8, C1.1, D8.1
/Arduino_buz_mute: A1.12, A2.24, R26.1
/Arduino_free_pin: A1.13, A2.25, D10.1
/Arduino_motor_ctrl1: A1.9, A2.21, J3.3, R6.1, U2.20
/Arduino_motor_ctrl2: A1.8, A2.20, J3.4, R3.1, U2.21
/Arduino_motor_fault: A1.7, A2.19, R16.2, U2.18
/Arduino_motor_reset: A1.10, A2.22, J3.2, R7.1, U2.16
/Arduino_ok_led: A1.6, A2.18, R21.2
/Arduino_posn_sns1: A1.5, A2.17, U3.6
/Arduino_posn_sns2: A1.11, A2.23, U3.4
/Arduino_switchX: A1.15, A2.27, U3.2
/SPI_CLK: A1.16, A2.28, J2.3
/SPI_MOSI: A1.14, A2.26, J2.4
/WarnLED: BZ1.2, D7.2, R18.2, U4.3
/out1: J4.1, J4.2, R13.1, U2.5, U2.10
/out2: D5.1, D6.2, J4.3, J4.4, U2.7, U2.8
GND: A1.4, A1.29, A2.6, A2.7, A2.29, A6.2, A7.2, C1.2, C2.2, C3.2, C4.2, C5.2, C6.2, C7.2, C8.2, C9.2, C10.2, C12.2, C14.2, C15.2, C16.2, C17.2, C18.2, C19.2, C20.2, C21.2, C22.2, C23.2, D3.1, D4.1, D10.2, J1.1, J1.2, J2.1, J3.1, J5.1, J6.1, J7.1, J8.1, J9.1, J9.3, R3.2, R6.2, R7.2, R11.2, R14.1, U1.2, U2.14, U2.28, U2.29, U3.7, U4.1
unnamed: A1.25, A6.1
unnamed: A1.26, A7.1
unnamed: C6.1, R10.1, U2.15
unnamed: C8.1, R10.2, R11.1, U2.12, U2.13
unnamed: C11.1, U2.2
unnamed: C11.2, U2.1
unnamed: C13.2, R20.2, U2.3
unnamed: C14.1, J5.3, U3.5
unnamed: C15.1, J6.3, U3.3
unnamed: C16.1, J7.2, R15.2, U3.9
unnamed: C17.1, R25.2, R26.2, U4.2, U4.6
unnamed: C18.1, U4.5
unnamed: C19.1, J7.4, R19.2, U3.13
unnamed: C20.1, J7.3, R17.2, U3.11
unnamed: C21.1, J9.2, R23.2, U3.1
unnamed: D2.2, J1.3
unnamed: D3.2, R1.2
unnamed: D4.2, R12.2
unnamed: D5.2, D6.1, R13.2
unnamed: J8.3, R21.1
unnamed: J8.4, R18.1
unnamed: J9.4, R22.2, TP4.1
unnamed: R2.1, U2.27
unnamed: R4.1, U2.26
unnamed: R5.1, U2.17
unnamed: R8.1, U2.25
unnamed: R9.1, U2.19
unnamed: R14.2, U2.6, U2.9
unnamed: R24.2, R25.1, U4.7
