BreathOfHope/Respirator-2/(commit log)

2020-04-02 Add electronics greb and sch files
    [BoHv0_1.bottom.gbr, BoHv0_1.bottommask.gbr, BoHv0_1.bottompaste.gbr, BoHv0_1.bottomsilk.gbr, BoHv0_1.fab.gbr, BoHv0_1.top.gbr, BoHv0_1.topmask.gbr, BoHv0_1.toppaste.gbr]
2020-04-02 Correct folder name
    [BoHv0_1.bottom.gbr, BoHv0_1.bottommask.gbr, BoHv0_1.bottompaste.gbr, BoHv0_1.bottomsilk.gbr, BoHv0_1.fab.gbr, BoHv0_1.top.gbr, BoHv0_1.topmask.gbr, BoHv0_1.toppaste.gbr]
2020-04-02 created readme for schematics
2020-04-02 created readme for gerber files
2020-04-03 This is the first set of drawings released to manufacturers. Includes parts that can be manufactured by turning and milling. Contributions from Vignesh Nagarajan, and the Respirator discussion group 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
2020-05-19 added electronics bom
    [BoHv1_assy.csv]
2020-05-19 added drawings for mechanical components and mechanical bom
    [1.5mm En8.dxf, 1mm En8.dxf, 2mm En8.dxf, 2mm black.dxf, 3mm En8.dxf, 3mm clear.dxf, 4mm clear.dxf, 5mm En8.dxf]
2020-05-19 updated readme on PCB wiring needed for Nano usage
2020-05-19 update readme for PCB changes
2020-05-20 versionB schematics - KiCad and pdf files
    BoHv0.1(beta) PCB was fabricated and needed some wirings for using Nano and the interrupts were suboptimal. Hence the new version schematics and PCB files. Yet to fabricate the BoHv1.0 PCB.
    Updated Arduino connections for optimised interrupt usage.
    D2 used for position sense, D3 usable as extra source of interrupt
    Swapped Arduino Nano's A6-A7 pin connections with its unused A4-A5 pins.
    [Resp2.sch]
2020-05-20 Moved v0.1 schematics to separate folder
    [DRV8842.sch]
2020-05-20 moved v0.1 gerber files to separate folder
    [BoHv0_1.bottom.gbr]
2020-05-20 added v1.0 files and moved v0.1 gerber files to subfolder
    BoHv0.1 PCB was manufactured and validated, based on which the BoHv1.0 gerbers are now generated, yet to be manufactured.
    PCB layout done with KiCad, project file(s) to be included.
    The PCB enhancements include,
    - using A4-A5 pins on the nano connector instead of A6-A7.
    - using D2 (external interrupt) for position sensor instead of D7 (pin change interrupt.)
    - D10 available as a free pin for user connections
    - D3 (external interrupt capable) usable as input, instead of driving external LED.
    [Resp2-B_Cu.gbr, Resp2-B_Mask.gbr, Resp2-B_Paste.gbr, Resp2-B_SilkS.gbr, Resp2-Edge_Cuts.gbr, Resp2-F_Cu.gbr, Resp2-F_Fab.gbr, Resp2-F_Mask.gbr]
2020-05-20 renamed file for v0.1 PCB
    [BoHv0_1_assy.csv]
2020-05-20 created directory for KiCad layout
2020-05-20 project and layout files for KiCad
    [Resp2.kicad_pcb]
2020-05-20 Created Resp2.pretty directory for footprints
2020-05-20 Added footprint files
2020-05-20 Added footprint file for every component on PCB
2020-05-20 moved BoM to a subdirectory
    [BoHv0_1_assy.csv]
2020-05-20 Updated BoM for v1.0 PCB
    [BoHv1_0_assy.csv]
2020-05-21 BoM already in separate folder
    [BoHv0_1_assy.csv]
2020-05-21 Updated gerber file
    [Resp2-B_Cu.gbr]
2020-05-21 renamed directory as PCB_Fabrication
    [Resp2-B_Cu.gbr]
2020-05-21 updated gerber renamed directory
    [Resp2-B_Mask.gbr]
2020-05-21 update file and renamed directory
    [Resp2-B_Paste.gbr]
2020-05-21 updated file and renamed directory
    [Resp2-B_SilkS.gbr]
2020-05-21 updated file renamed folder
    [Resp2-F_Cu.gbr]
2020-05-21 updated file and renamed folder
    [Resp2-F_Mask.gbr]
2020-05-21 updated readme for BoHv1_0 PCB
2020-05-21 renamed directory
    [BoHv0_1.bottom.gbr]
2020-05-21 added 3D views of the BoHv1_0 PCB
